doccaz/mister-tty2oled-esp32/docs/protocol.md

# Wire protocol

115200 baud, line-based ASCII commands terminated by `\n`. The firmware
sends `ttyrdy;` once after boot, then `ttyack;` (no trailing newline)
after each processed command, unless `CMDSTTYACK,0` disables it — the
same handshake the original `tty2oled.sh` daemon expects.

**Commands compatible with the original protocol** (same behavior as
upstream, so an unmodified MiSTer daemon works unchanged):
`CMDCLS`/`cls`, `CMDCLSWU`, `CMDSORG`/`sorg`, `CMDCON,<0-255>`,
`CMDROT,<0|1>`, `CMDTXT,x,y,size,text`, `CMDGEO,type,x,y,w,h,fill`,
`CMDSNAM`, `CMDDOFF`, `CMDDON`, `CMDDUPD`, `CMDSECD,<ms>`, `CMDSHCD`,
`CMDSTTYACK,<0|1>`, `CMDRESET`, `CMDSAVER,<mode>,<interval>,<logotime>`
(parses the original's full grammar; implements simple blank-after-idle,
not its animated multi-screen screensaver), `CMDSWSAVER,<0|1>`, and a
bare line with no `CMD` prefix (legacy plain-corename fallback).

**Also implemented, new but original-protocol-shaped**: `CMDBYE`,
`CMDTEST`, `CMDSHSYSHW` (cosmetic/diagnostic screens built from
primitives, not the original's bitmap assets), `CMDHWINF` (replies
`HW<id>;<version>;`: `HWGC9A01C`, or `HWCYD28` on the CYD), `CMDCLST,<transition>,<color>` (solid-color
fill), `CMDSPIC[,<effect>]` (redisplay the last picture with a new
transition), `CMDSSCP` (redisplay at reduced size), `CMDSETTIME,<epoch>`
(sets the device clock; `tty2oled.sh` sends it at startup) and `CMDSHTIME`
(shows the clock as HH:MM plus date; not persisted across reboots).

**Legacy picture transfer**: `CMDCOR,<name>,<effect>` or `CMDAPD,...`
followed by a blocking, fixed-size read of exactly 2048 (1bpp XBM) or
8192 (4bpp grayscale "GSC") raw bytes, classified purely by byte count —
identical to upstream. Source images are 256×64; on the round display
they're scaled to fit (not cropped), since the safe display area is the
same 4:1 aspect ratio as the source.

**Full-color art**: `CMDCORC,<name>,<effect>,<durationMs>,<length>\n`
followed by exactly `<length>` raw JPEG bytes, length-prefixed (not
size-classified, so it isn't subject to the legacy path's fixed-size
truncation behavior). Decoded on-device and revealed with a transition
effect over `durationMs`. Effect ids (shared between firmware and web
app):

| id | effect |
|---|---|
| 0 | none (instant cut) |
| 1 | wipe left → right |
| 2 | wipe right → left |
| 3 | wipe top → bottom |
| 4 | iris (expand from center) |
| 5 | fade (cross-dissolve) |

## Over WiFi

The same command grammar is also reachable over a WebSocket on port 81
once the device has joined your network (see [First boot: WiFi
setup](setup.md#first-boot-wifi-setup)) — `ws://tty2oled-XXXX.local:81/`,
advertised via mDNS as `_ws._tcp`. `CMDCORC`'s JPEG payload is sent as a
text header frame followed by the image chunked into small binary
frames, rather than one big length-prefixed blob — this keeps every
allocation the device's WebSocket library needs to make small and
constant regardless of image size. Legacy `CMDCOR`/`CMDAPD` (raw
XBM/GSC) aren't supported over this transport — that grammar exists for
real-MiSTer-over-serial compatibility, and a WiFi client always has the
modern JPEG path available instead.
