doccaz/mister-tty2oled-esp32/case/sunton_2424s012_stand.stl

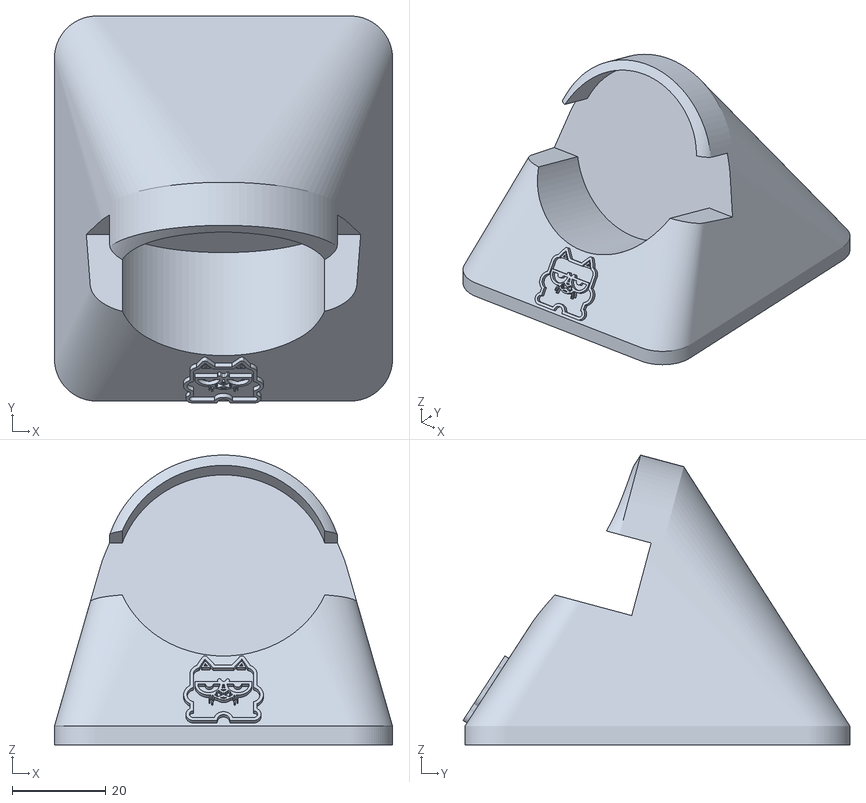
[picture p6: CAD file, 2026-10-17]
case/sunton_2424s012_stand.stl
72.0 x 82.4 x 61.7
