doccaz/mister-tty2oled-esp32/case/sunton_2424s012_back.stl

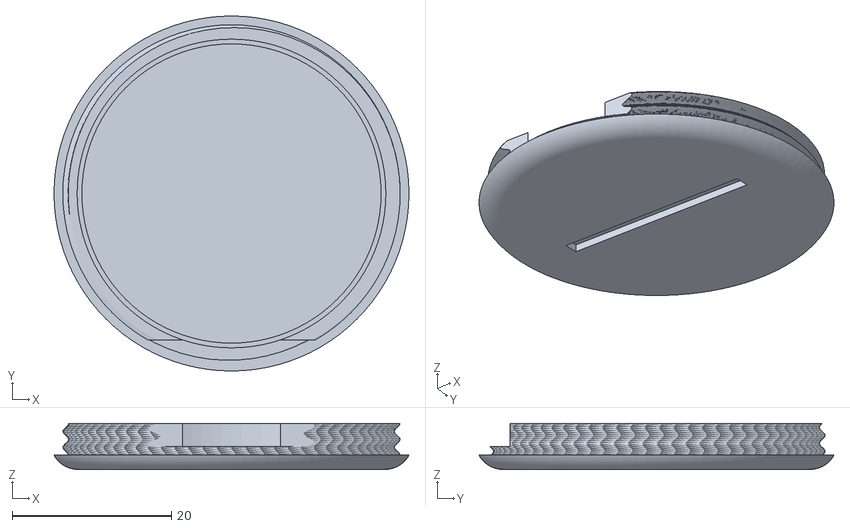
[picture p7: CAD file, 2026-10-17]
case/sunton_2424s012_back.stl
44.6 x 44.6 x 5.79
