doccaz/mister-tty2oled-esp32/case/sunton_2424s012_front.stl

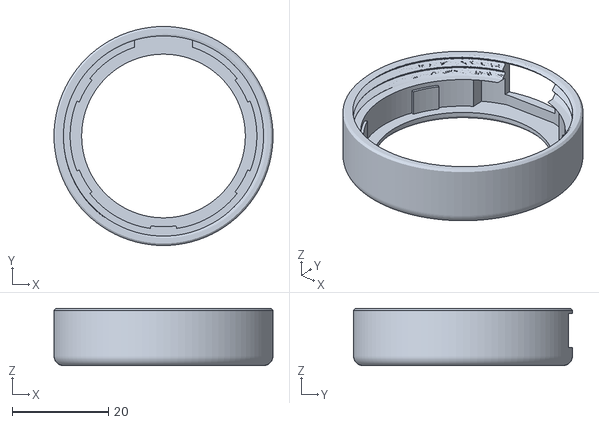
[picture p8: CAD file, 2026-10-17]
case/sunton_2424s012_front.stl
45.5 x 45.5 x 11.9
