doccaz/mister-tty2oled-esp32/case/mister_kun_logo.scad

// MiSTer-Kun mascot, black layer only (outline, glasses, eyes, nose, whiskers), as one 2D
// polygon (even-odd holes), centred and normalised to width 1. Height is 0.9647.
// Artwork: "MiSTer-Kun", created by GitHub user HeWhoisRed for the MiSTer FPGA project and
// remastered by baxysquare (https://github.com/baxysquare/mister_kun), a gift to the MiSTer
// community to use and remix as people wish; a simple credit is appreciated (see
// mister_kun_CREDITS.txt). Derived from mister_kun_bw.svg by compositing its black and white
// layers and simplifying the curves.
kun_h = 0.96474;
module kun_logo2d() {
  polygon(points = [[-0.07341,-0.45040],[-0.07008,-0.44086],[-0.06294,-0.42783],[-0.05354,-0.41658],[-0.04221,-0.40738],[-0.02931,-0.40047],[-0.02000,-0.39728],[-0.00524,-0.39480],[0.00493,-0.39480],[0.01969,-0.39728],[0.03345,-0.40250],[0.04587,-0.41020],[0.05659,-0.42012],[0.06528,-0.43199],[0.06977,-0.44086],[0.07310,-0.45040],[0.08190,-0.48237],[0.38303,-0.48209],[0.39731,-0.47991],[0.41087,-0.47570],[0.42352,-0.46962],[0.43506,-0.46183],[0.44533,-0.45248],[0.45412,-0.44172],[0.46125,-0.42973],[0.46655,-0.41664],[0.46981,-0.40263],[0.47083,-0.39117],[0.47070,-0.38293],[0.46829,-0.36689],[0.46314,-0.35164],[0.45535,-0.33747],[0.44504,-0.32463],[0.43335,-0.31419],[0.41895,-0.30515],[0.41908,-0.23328],[0.43018,-0.22661],[0.44071,-0.21905],[0.45058,-0.21064],[0.45973,-0.20143],[0.46808,-0.19146],[0.47681,-0.17887],[0.48188,-0.17011],[0.48834,-0.15648],[0.49340,-0.14231],[0.49599,-0.13261],[0.49795,-0.12273],[0.49967,-0.10760],[0.49992,-0.09221],[0.49926,-0.08202],[0.49795,-0.07198],[0.49478,-0.05722],[0.49018,-0.04289],[0.48418,-0.02907],[0.47681,-0.01583],[0.46607,-0.00069],[0.45753,0.00908],[0.44577,0.02021],[0.43294,0.03006],[0.41917,0.03852],[0.41908,0.22211],[0.41842,0.23128],[0.41620,0.24480],[0.41256,0.25796],[0.40753,0.27064],[0.40115,0.28272],[0.39618,0.29039],[0.38766,0.30124],[0.37862,0.31055],[0.36876,0.31883],[0.35815,0.32605],[0.34689,0.33215],[0.33506,0.33709],[0.31995,0.36620],[0.30288,0.39628],[0.28283,0.42972],[0.25980,0.46633],[0.25302,0.47414],[0.24760,0.47792],[0.24167,0.48056],[0.23221,0.48236],[0.22262,0.48152],[0.21350,0.47803],[0.20548,0.47185],[0.10549,0.34458],[-0.10679,0.34458],[-0.20678,0.47185],[-0.21481,0.47803],[-0.22392,0.48152],[-0.23351,0.48236],[-0.24297,0.48056],[-0.24890,0.47792],[-0.25432,0.47414],[-0.26110,0.46633],[-0.28423,0.42955],[-0.30439,0.39592],[-0.32152,0.36570],[-0.33664,0.33652],[-0.35110,0.33004],[-0.36201,0.32360],[-0.37470,0.31405],[-0.38398,0.30527],[-0.39400,0.29341],[-0.40152,0.28210],[-0.40776,0.27011],[-0.41269,0.25754],[-0.41714,0.24008],[-0.41908,0.22206],[-0.41917,0.03852],[-0.43558,0.02820],[-0.45061,0.01591],[-0.46401,0.00182],[-0.47681,-0.01583],[-0.48634,-0.03362],[-0.49340,-0.05239],[-0.49795,-0.07198],[-0.49967,-0.08710],[-0.49967,-0.10760],[-0.49705,-0.12769],[-0.49478,-0.13749],[-0.49018,-0.15181],[-0.48187,-0.17011],[-0.47113,-0.18734],[-0.46400,-0.19653],[-0.45525,-0.20613],[-0.44818,-0.21282],[-0.43814,-0.22102],[-0.42746,-0.22837],[-0.41907,-0.23328],[-0.41895,-0.30515],[-0.42871,-0.31088],[-0.43781,-0.31778],[-0.44504,-0.32463],[-0.45300,-0.33412],[-0.45753,-0.34090],[-0.46313,-0.35164],[-0.46725,-0.36299],[-0.46915,-0.37083],[-0.47085,-0.38703],[-0.46981,-0.40263],[-0.46654,-0.41664],[-0.46125,-0.42973],[-0.45790,-0.43587],[-0.44991,-0.44727],[-0.44036,-0.45734],[-0.42944,-0.46593],[-0.41732,-0.47289],[-0.40419,-0.47805],[-0.39025,-0.48126],[-0.38303,-0.48209],[-0.08221,-0.48237],[-0.37707,-0.43885],[-0.38522,-0.43819],[-0.39663,-0.43490],[-0.40355,-0.43131],[-0.41262,-0.42412],[-0.41981,-0.41505],[-0.42339,-0.40814],[-0.42668,-0.39673],[-0.42734,-0.38857],[-0.42664,-0.38042],[-0.42317,-0.36900],[-0.41941,-0.36209],[-0.41190,-0.35302],[-0.40253,-0.34583],[-0.39543,-0.34225],[-0.38384,-0.33895],[-0.37564,-0.33830],[-0.37564,-0.20431],[-0.38924,-0.19948],[-0.39572,-0.19644],[-0.40795,-0.18918],[-0.41911,-0.18047],[-0.42907,-0.17043],[-0.43355,-0.16496],[-0.44146,-0.15318],[-0.44484,-0.14690],[-0.45041,-0.13367],[-0.45424,-0.11964],[-0.45547,-0.11235],[-0.45648,-0.09735],[-0.45547,-0.08235],[-0.45424,-0.07507],[-0.45041,-0.06103],[-0.44484,-0.04780],[-0.44146,-0.04153],[-0.43355,-0.02975],[-0.42425,-0.01910],[-0.41367,-0.00971],[-0.40795,-0.00552],[-0.39572,0.00173],[-0.38924,0.00477],[-0.37564,0.00961],[-0.37542,0.22369],[-0.37475,0.22977],[-0.37214,0.24150],[-0.36796,0.25254],[-0.36232,0.26277],[-0.35536,0.27207],[-0.35142,0.27632],[-0.34271,0.28398],[-0.33796,0.28734],[-0.32778,0.29306],[-0.32238,0.29539],[-0.31102,0.29889],[-0.30510,0.30004],[-0.29575,0.32112],[-0.27759,0.35517],[-0.25751,0.38962],[-0.23101,0.43259],[-0.16065,0.34307],[-0.12858,0.30106],[0.12728,0.30106],[0.15935,0.34307],[0.22971,0.43259],[0.25614,0.38973],[0.27618,0.35535],[0.29435,0.32133],[0.30377,0.30022],[0.30979,0.29916],[0.32134,0.29577],[0.33213,0.29083],[0.34204,0.28447],[0.35092,0.27681],[0.35865,0.26800],[0.36510,0.25816],[0.36779,0.25289],[0.37207,0.24175],[0.37361,0.23591],[0.37541,0.22376],[0.37564,0.21749],[0.37564,0.00961],[0.38924,0.00478],[0.40196,-0.00171],[0.41368,-0.00971],[0.41911,-0.01424],[0.42907,-0.02427],[0.43769,-0.03550],[0.44485,-0.04780],[0.45041,-0.06103],[0.45424,-0.07507],[0.45622,-0.08978],[0.45648,-0.09735],[0.45547,-0.11235],[0.45424,-0.11963],[0.45041,-0.13367],[0.44783,-0.14040],[0.44146,-0.15318],[0.43769,-0.15920],[0.42907,-0.17043],[0.41911,-0.18047],[0.41368,-0.18500],[0.40196,-0.19300],[0.39572,-0.19644],[0.38255,-0.20211],[0.37564,-0.20431],[0.37564,-0.33830],[0.38781,-0.33976],[0.39544,-0.34225],[0.40253,-0.34583],[0.40897,-0.35040],[0.41463,-0.35585],[0.42142,-0.36547],[0.42463,-0.37268],[0.42664,-0.38042],[0.42717,-0.39269],[0.42478,-0.40446],[0.42173,-0.41168],[0.41764,-0.41826],[0.40978,-0.42674],[0.40017,-0.43323],[0.38915,-0.43739],[0.38119,-0.43868],[0.11506,-0.43885],[0.10994,-0.42410],[0.10669,-0.41707],[0.09892,-0.40380],[0.08956,-0.39169],[0.08433,-0.38611],[0.07286,-0.37601],[0.06015,-0.36743],[0.05338,-0.36375],[0.03909,-0.35770],[0.02393,-0.35354],[0.01606,-0.35220],[-0.00015,-0.35111],[-0.01637,-0.35220],[-0.02424,-0.35354],[-0.03940,-0.35770],[-0.05369,-0.36375],[-0.06046,-0.36743],[-0.07317,-0.37601],[-0.07907,-0.38088],[-0.08987,-0.39169],[-0.09923,-0.40380],[-0.10700,-0.41707],[-0.11025,-0.42410],[-0.11537,-0.43885],[-0.17130,0.31120],[-0.16840,0.31222],[-0.16595,0.31490],[-0.16516,0.31846],[-0.16599,0.32142],[-0.21692,0.39398],[-0.22131,0.39803],[-0.22664,0.39980],[-0.23217,0.39936],[-0.23716,0.39676],[-0.24084,0.39206],[-0.27533,0.32116],[-0.27603,0.31765],[-0.27459,0.31386],[-0.27191,0.31175],[-0.26907,0.31115],[-0.24402,0.33378],[-0.22695,0.36888],[-0.20229,0.33378],[0.26983,0.31119],[0.27312,0.31244],[0.27531,0.31502],[0.27604,0.31835],[0.27534,0.32116],[0.24009,0.39343],[0.23601,0.39761],[0.23350,0.39891],[0.22943,0.39985],[0.22526,0.39957],[0.22258,0.39868],[0.21789,0.39520],[0.16643,0.32212],[0.16516,0.31846],[0.16541,0.31627],[0.16675,0.31368],[0.16906,0.31185],[0.17130,0.31120],[0.20229,0.33378],[0.22695,0.36888],[0.24403,0.33378],[-0.14035,-0.22001],[-0.13642,-0.21830],[-0.13424,-0.21465],[-0.13288,-0.19068],[-0.13127,-0.18075],[-0.12636,-0.16317],[-0.11977,-0.14848],[-0.11094,-0.13498],[-0.10281,-0.14055],[-0.09536,-0.14418],[-0.08743,-0.14679],[-0.07820,-0.14855],[-0.07480,-0.14998],[-0.05131,-0.16509],[-0.04087,-0.16983],[-0.03018,-0.17309],[-0.01998,-0.17515],[0.00108,-0.17674],[0.01381,-0.17628],[0.02476,-0.17508],[0.03657,-0.17280],[0.04675,-0.16977],[0.05413,-0.16644],[0.08194,-0.14891],[0.09171,-0.14679],[0.09963,-0.14418],[0.10708,-0.14055],[0.11234,-0.13716],[0.11937,-0.14812],[0.12292,-0.15515],[0.12891,-0.17135],[0.13284,-0.19056],[0.13457,-0.21570],[0.13642,-0.21830],[0.13873,-0.21966],[0.14160,-0.22002],[0.14466,-0.21902],[0.14718,-0.21635],[0.14799,-0.21318],[0.14773,-0.20019],[0.14662,-0.18813],[0.14474,-0.17696],[0.14218,-0.16666],[0.13543,-0.14854],[0.13141,-0.14066],[0.12295,-0.12768],[0.13115,-0.11660],[0.13341,-0.11074],[0.13505,-0.10402],[0.14200,-0.11085],[0.14819,-0.11818],[0.15361,-0.12603],[0.16032,-0.13875],[0.16384,-0.14786],[0.16660,-0.15747],[0.16858,-0.16757],[0.17016,-0.18419],[0.17098,-0.18673],[0.17306,-0.18905],[0.17598,-0.19024],[0.17902,-0.19005],[0.18182,-0.18846],[0.18339,-0.18631],[0.18404,-0.18365],[0.18273,-0.16821],[0.18019,-0.15463],[0.17657,-0.14228],[0.17204,-0.13112],[0.16677,-0.12110],[0.15785,-0.10807],[0.15033,-0.09950],[0.17426,-0.10234],[0.19793,-0.10209],[0.21825,-0.09945],[0.23794,-0.09461],[0.25684,-0.08764],[0.27478,-0.07859],[0.29160,-0.06754],[0.30714,-0.05455],[0.32124,-0.03965],[0.33323,-0.02348],[0.34303,-0.00620],[0.35060,0.01204],[0.35585,0.03107],[0.35872,0.05076],[0.35927,0.09272],[0.35807,0.09693],[0.35494,0.09983],[0.35127,0.10072],[0.07103,0.10072],[0.07505,0.10949],[0.07637,0.11453],[0.07627,0.12161],[0.07471,0.12684],[0.07088,0.13288],[0.06543,0.13748],[0.05878,0.14024],[0.05325,0.14086],[0.04527,0.13935],[0.04104,0.13720],[0.03737,0.13427],[0.03280,0.12793],[0.03001,0.11977],[0.02731,0.11456],[0.02148,0.10758],[0.01444,0.10304],[0.01002,0.10151],[0.00494,0.10068],[-0.00068,0.10068],[-0.00596,0.10155],[-0.01080,0.10332],[-0.01526,0.10602],[-0.01938,0.10966],[-0.02389,0.11525],[-0.02769,0.12191],[-0.03073,0.12968],[-0.03462,0.13452],[-0.03830,0.13737],[-0.04252,0.13944],[-0.05046,0.14087],[-0.05587,0.14026],[-0.06234,0.13768],[-0.06764,0.13337],[-0.07144,0.12764],[-0.07340,0.12082],[-0.07337,0.11454],[-0.07187,0.10904],[-0.06777,0.10072],[-0.35126,0.10072],[-0.35548,0.09952],[-0.35807,0.09693],[-0.35924,0.09337],[-0.35913,0.05743],[-0.35707,0.03757],[-0.35261,0.01830],[-0.34833,0.00586],[-0.34303,-0.00620],[-0.33322,-0.02348],[-0.32124,-0.03965],[-0.30714,-0.05455],[-0.29160,-0.06754],[-0.27478,-0.07859],[-0.25684,-0.08764],[-0.23794,-0.09461],[-0.21825,-0.09945],[-0.19792,-0.10209],[-0.17337,-0.10229],[-0.15033,-0.09950],[-0.15784,-0.10808],[-0.16677,-0.12110],[-0.17204,-0.13112],[-0.17657,-0.14228],[-0.18019,-0.15463],[-0.18273,-0.16821],[-0.18403,-0.18365],[-0.18338,-0.18631],[-0.18181,-0.18846],[-0.17902,-0.19005],[-0.17598,-0.19024],[-0.17306,-0.18905],[-0.17098,-0.18673],[-0.17016,-0.18420],[-0.16858,-0.16757],[-0.16659,-0.15747],[-0.16384,-0.14786],[-0.16032,-0.13875],[-0.15361,-0.12603],[-0.14818,-0.11818],[-0.14200,-0.11085],[-0.13129,-0.10081],[-0.12982,-0.10831],[-0.12747,-0.11537],[-0.12090,-0.12510],[-0.12709,-0.13353],[-0.13543,-0.14854],[-0.14218,-0.16666],[-0.14473,-0.17696],[-0.14662,-0.18813],[-0.14773,-0.20019],[-0.14796,-0.21375],[-0.14718,-0.21635],[-0.14552,-0.21840],[-0.14321,-0.21970],[-0.19526,-0.06562],[-0.20616,-0.06440],[-0.21679,-0.06240],[-0.22711,-0.05965],[-0.24669,-0.05204],[-0.26463,-0.04182],[-0.28065,-0.02926],[-0.28786,-0.02217],[-0.30050,-0.00655],[-0.30587,0.00192],[-0.31056,0.01079],[-0.31454,0.02003],[-0.31777,0.02960],[-0.32022,0.03948],[-0.32185,0.04962],[-0.32263,0.06035],[-0.32128,0.06315],[-0.31863,0.06416],[-0.22866,0.06416],[-0.22751,0.05630],[-0.22369,0.04535],[-0.21988,0.03874],[-0.21250,0.03010],[-0.20340,0.02328],[-0.19653,0.01989],[-0.18527,0.01678],[-0.17725,0.01616],[-0.16923,0.01678],[-0.15797,0.01989],[-0.15110,0.02328],[-0.14200,0.03010],[-0.13462,0.03874],[-0.13081,0.04535],[-0.12699,0.05630],[-0.12585,0.06416],[-0.04958,0.06416],[-0.04649,0.06270],[-0.04557,0.06001],[-0.04636,0.04962],[-0.04799,0.03948],[-0.05044,0.02960],[-0.05367,0.02003],[-0.05764,0.01079],[-0.06770,-0.00655],[-0.08035,-0.02217],[-0.08756,-0.02926],[-0.10358,-0.04182],[-0.11232,-0.04724],[-0.13112,-0.05619],[-0.14109,-0.05965],[-0.16204,-0.06440],[-0.17295,-0.06562],[-0.18410,-0.06604],[0.17295,-0.06562],[0.16205,-0.06440],[0.15142,-0.06240],[0.14110,-0.05965],[0.12152,-0.05204],[0.10358,-0.04182],[0.08756,-0.02926],[0.08035,-0.02217],[0.06771,-0.00655],[0.06234,0.00192],[0.05367,0.02003],[0.05044,0.02960],[0.04799,0.03948],[0.04636,0.04962],[0.04558,0.06035],[0.04693,0.06315],[0.04958,0.06416],[0.12585,0.06416],[0.12699,0.05630],[0.13081,0.04535],[0.13462,0.03874],[0.14201,0.03010],[0.15111,0.02328],[0.15797,0.01989],[0.16924,0.01678],[0.17725,0.01616],[0.18527,0.01678],[0.19653,0.01989],[0.20340,0.02328],[0.21250,0.03010],[0.21988,0.03874],[0.22369,0.04535],[0.22751,0.05630],[0.22866,0.06416],[0.31863,0.06416],[0.32172,0.06270],[0.32264,0.06001],[0.32185,0.04962],[0.32022,0.03948],[0.31777,0.02960],[0.31454,0.02003],[0.31057,0.01079],[0.30051,-0.00655],[0.29449,-0.01459],[0.28065,-0.02926],[0.26463,-0.04182],[0.25588,-0.04724],[0.23709,-0.05619],[0.22712,-0.05965],[0.20616,-0.06440],[0.19526,-0.06562],[0.18411,-0.06604],[-0.01940,0.00676],[-0.01517,0.01932],[-0.01200,0.03221],[-0.00990,0.04539],[-0.00901,0.05611],[0.00052,0.05532],[0.00931,0.05561],[0.01053,0.04255],[0.01279,0.02973],[0.01609,0.01719],[0.02038,0.00498],[-0.00016,0.00609],[-0.02037,0.00429],[-0.00004,-0.05023],[-0.00246,-0.04414],[-0.00821,-0.03760],[-0.01755,-0.03170],[-0.03168,-0.02657],[-0.03254,-0.02524],[-0.03197,-0.02375],[-0.02696,-0.02162],[-0.01799,-0.01960],[0.00000,-0.01830],[0.01799,-0.01960],[0.02696,-0.02162],[0.03212,-0.02391],[0.03251,-0.02544],[0.03168,-0.02657],[0.01756,-0.03170],[0.00821,-0.03760],[0.00246,-0.04414],[0.06203,-0.12352],[0.04783,-0.11949],[0.03430,-0.11338],[0.01677,-0.10274],[0.00000,-0.08976],[-0.01199,-0.09935],[-0.02213,-0.10630],[-0.03430,-0.11338],[-0.04782,-0.11948],[-0.06203,-0.12352],[-0.06918,-0.12442],[-0.07625,-0.12438],[-0.08314,-0.12328],[-0.08979,-0.12097],[-0.09443,-0.11827],[-0.08622,-0.11254],[-0.07691,-0.10711],[-0.07579,-0.10529],[-0.07525,-0.10268],[-0.07659,-0.09850],[-0.08001,-0.09599],[-0.08430,-0.09595],[-0.09601,-0.10227],[-0.10474,-0.10870],[-0.10736,-0.10541],[-0.10874,-0.10103],[-0.10965,-0.09485],[-0.10935,-0.08672],[-0.09727,-0.08152],[-0.08544,-0.07794],[-0.08277,-0.07613],[-0.08108,-0.07282],[-0.08121,-0.06951],[-0.08282,-0.06666],[-0.08547,-0.06490],[-0.08957,-0.06466],[-0.10217,-0.06846],[-0.09797,-0.06289],[-0.09059,-0.05561],[-0.06901,-0.03767],[-0.05881,-0.03000],[-0.05798,-0.03533],[-0.05614,-0.04049],[-0.05266,-0.04598],[-0.04916,-0.04934],[-0.04176,-0.05317],[-0.03130,-0.05467],[-0.02982,-0.05866],[-0.02734,-0.06253],[-0.02310,-0.06665],[-0.01910,-0.06917],[-0.01100,-0.07204],[0.00000,-0.07316],[0.01100,-0.07204],[0.01910,-0.06917],[0.02311,-0.06665],[0.02734,-0.06253],[0.02983,-0.05866],[0.03130,-0.05467],[0.04176,-0.05317],[0.04916,-0.04934],[0.05266,-0.04598],[0.05614,-0.04049],[0.05798,-0.03533],[0.05881,-0.03000],[0.06901,-0.03767],[0.09059,-0.05561],[0.09798,-0.06289],[0.10218,-0.06846],[0.08957,-0.06466],[0.08548,-0.06489],[0.08248,-0.06706],[0.08109,-0.07005],[0.08122,-0.07333],[0.08277,-0.07612],[0.08544,-0.07794],[0.09718,-0.08148],[0.10935,-0.08671],[0.10965,-0.08959],[0.10965,-0.09485],[0.10874,-0.10103],[0.10736,-0.10541],[0.10474,-0.10870],[0.09601,-0.10227],[0.08430,-0.09596],[0.08212,-0.09563],[0.07951,-0.09618],[0.07730,-0.09767],[0.07600,-0.09945],[0.07535,-0.10376],[0.07729,-0.10752],[0.08850,-0.11409],[0.09431,-0.11835],[0.08979,-0.12097],[0.08314,-0.12328],[0.07625,-0.12438],[0.06918,-0.12442],[-0.00369,-0.15231],[-0.01413,-0.15148],[-0.02289,-0.14996],[-0.03187,-0.14746],[-0.04031,-0.14383],[-0.03155,-0.13980],[-0.01877,-0.13703],[0.00121,-0.13577],[0.01756,-0.13681],[0.03090,-0.14001],[0.03694,-0.14292],[0.04032,-0.14573],[0.03201,-0.14855],[0.02041,-0.15094],[0.00766,-0.15218]],
          paths = [[0,1,2,3,4,5,6,7,8,9,10,11,12,13,14,15,16,17,18,19,20,21,22,23,24,25,26,27,28,29,30,31,32,33,34,35,36,37,38,39,40,41,42,43,44,45,46,47,48,49,50,51,52,53,54,55,56,57,58,59,60,61,62,63,64,65,66,67,68,69,70,71,72,73,74,75,76,77,78,79,80,81,82,83,84,85,86,87,88,89,90,91,92,93,94,95,96,97,98,99,100,101,102,103,104,105,106,107,108,109,110,111,112,113,114,115,116,117,118,119,120,121,122,123,124,125,126,127,128,129,130,131,132,133,134,135,136,137,138,139,140,141,142,143,144,145,146,147,148,149,150],[151,152,153,154,155,156,157,158,159,160,161,162,163,164,165,166,167,168,169,170,171,172,173,174,175,176,177,178,179,180,181,182,183,184,185,186,187,188,189,190,191,192,193,194,195,196,197,198,199,200,201,202,203,204,205,206,207,208,209,210,211,212,213,214,215,216,217,218,219,220,221,222,223,224,225,226,227,228,229,230,231,232,233,234,235,236,237,238,239,240,241,242,243,244,245,246,247,248,249,250,251,252,253,254,255,256,257,258,259,260,261,262,263,264,265,266,267,268,269,270,271,272,273,274,275,276,277,278,279,280,281,282,283,284,285,286,287,288,289,290,291,292,293,294,295,296,297],[298,299,300,301,302,303,304,305,306,307,308,309,310,311,312,313],[314,315,316],[317,318,319,320,321,322,323,324,325,326,327,328,329,330,331,332,333,334],[335,336,337],[338,339,340,341,342,343,344,345,346,347,348,349,350,351,352,353,354,355,356,357,358,359,360,361,362,363,364,365,366,367,368,369,370,371,372,373,374,375,376,377,378,379,380,381,382,383,384,385,386,387,388,389,390,391,392,393,394,395,396,397,398,399,400,401,402,403,404,405,406,407,408,409,410,411,412,413,414,415,416,417,418,419,420,421,422,423,424,425,426,427,428,429,430,431,432,433,434,435,436,437,438,439,440,441,442,443,444,445,446,447,448,449,450,451,452,453,454,455,456,457,458,459,460,461,462,463,464,465,466,467,468,469,470,471,472,473,474,475,476,477,478,479,480,481,482,483,484,485,486,487,488,489,490,491,492,493,494,495,496,497,498,499,500,501,502,503,504,505,506,507,508,509,510,511,512,513,514,515,516,517,518,519,520],[521,522,523,524,525,526,527,528,529,530,531,532,533,534,535,536,537,538,539,540,541,542,543,544,545,546,547,548,549,550,551,552,553,554,555,556,557,558,559,560,561,562,563,564,565,566,567,568,569,570,571,572,573],[574,575,576,577,578,579,580,581,582,583,584,585,586,587,588,589,590,591,592,593,594,595,596,597,598,599,600,601,602,603,604,605,606,607,608,609,610,611,612,613,614,615,616,617,618,619,620,621,622,623,624,625],[626,627,628,629,630,631,632,633,634,635,636,637,638],[639,640,641,642,643,644,645,646,647,648,649,650,651,652,653,654,655,656],[657,658,659,660,661,662,663,664,665,666,667,668,669,670,671,672,673,674,675,676,677,678,679,680,681,682,683,684,685,686,687,688,689,690,691,692,693,694,695,696,697,698,699,700,701,702,703,704,705,706,707,708,709,710,711,712,713,714,715,716,717,718,719,720,721,722,723,724,725,726,727,728,729,730,731,732,733,734,735,736,737,738,739,740,741,742,743,744,745,746,747,748,749,750,751,752,753],[754,755,756,757,758,759,760,761,762,763,764,765,766,767,768]]);
}
