doccaz/mister-tty2oled-esp32/firmware/src/pins.h

// SPDX-License-Identifier: GPL-3.0-or-later
// Copyright (C) 2026 Erico Mendonca

#pragma once

// -----------------------------------------------------------------------
// GPIO pin assignments for the ESP32-C3-mini + GC9A01 round display.
// Edit this block to match your board's actual silkscreen/wiring - these
// are sane defaults that avoid the C3's strapping pins (GPIO2, 8, 9), its
// fixed native-USB pins (GPIO18/19, used automatically by Serial and never
// wired here), the in-package flash pins on FN4/FH4 modules (GPIO11-17),
// and GPIO5/6, which this board's onboard 0.42" SSD1306 OLED (72x40,
// driven as a 128x64 panel) uses as fixed I2C SDA/SCL - not
// user-selectable, since it's built into the board rather than wired by
// hand. GPIO20/21 are deliberately left unclaimed for the Serial0 debug
// UART (see protocol.cpp's DBG_ENABLED).
// -----------------------------------------------------------------------

// Panel geometry and bus. Every board but the CYD drives a 240x240 round GC9A01 over the
// global SPI; the CYD is a 320x240 ILI9341 on HSPI. The firmware always draws a 240x240
// canvas, which the driver places PANEL_OFF_X/Y into the panel.
#if defined(BOARD_CYD)
// ESP32-2432S028 "Cheap Yellow Display" (classic ESP32). Pins from the ASCII-Aquarium
// projects; colour settings (inversion off, RGB order, landscape) and the pins confirmed
// by a probe on the owner's board (2026-10-24).
#define PANEL_ILI9341 1
#define PANEL_W      320
#define PANEL_H      240
#define PANEL_OFF_X  40
#define PANEL_OFF_Y  0
#define LCD_SPI      lcdSpi
#define LCD_SPI_HZ   40000000
#define PIN_LCD_SCLK 14
#define PIN_LCD_MOSI 13
#define PIN_LCD_MISO 12
#define PIN_LCD_CS   15
#define PIN_LCD_DC   2
#define PIN_LCD_RST  4    // also the red LED; pulsed at boot, then held high (LED off)
#define PIN_LCD_BL   21   // PWM works
#define PIN_LED_G    16   // RGB LED is active low: drive high to switch it off
#define PIN_LED_B    17
#define PIN_LDR      34   // photoresistor divider, ADC1 (input only)
// XPT2046 resistive touch on its own pins (read with software SPI, see touch.cpp)
#define PIN_TOUCH_CS   33
#define PIN_TOUCH_CLK  25
#define PIN_TOUCH_MOSI 32
#define PIN_TOUCH_MISO 39
#define PIN_TOUCH_IRQ  36
#elif defined(BOARD_2424S012)
// Sunton ESP32-2424S012C (1.28" round, all-in-one ESP32-C3-MINI-1U board).
// Display is soldered on, pins fixed by the board. RST is not routed to a
// GPIO (tied to the board reset), so PIN_LCD_RST is -1 and gc9a01.cpp
// uses the SWRESET command instead. Capacitive-touch variants wire
// CST816S to GPIO0/1/4/5; this firmware doesn't use touch.
#define PIN_LCD_SCLK 6
#define PIN_LCD_MOSI 7
#define PIN_LCD_CS   10
#define PIN_LCD_DC   2
#define PIN_LCD_RST  -1
#define PIN_LCD_BL   3   // backlight, must be PWM (LEDC) capable
#else
#define PIN_LCD_SCLK 4
#define PIN_LCD_MOSI 0
#define PIN_LCD_CS   7
#define PIN_LCD_DC   1
#define PIN_LCD_RST  10
#define PIN_LCD_BL   3   // backlight, must be PWM (LEDC) capable
#endif

#ifndef PANEL_W
#define PANEL_W      240
#define PANEL_H      240
#define PANEL_OFF_X  0
#define PANEL_OFF_Y  0
#define LCD_SPI      SPI
#define LCD_SPI_HZ   10000000
#endif

// GC9A01 panels are write-only in this design; no MISO wiring needed.

// Onboard 0.42" SSD1306 OLED (72x40 visible, 128x64 controller RAM),
// status display. Fixed pins on this board variant.
#define PIN_OLED_SDA 5
#define PIN_OLED_SCL 6

// Onboard "BOOT" pushbutton, repurposed at runtime as a screensaver wake
// button, an AP-mode WiFi-QR toggle, and a factory-reset trigger when
// held 10s continuously (all in protocol.cpp's protocol_button_check()).
// GPIO9 is a strapping pin (pulled low at reset = download mode) - that
// only matters during the reset/power-on instant, not while running, so
// reading it as a plain input afterward is safe - but it also means the
// factory-reset hold must start *after* boot, not across a physical
// power-cycle/reset (holding it low through reset puts the ROM
// bootloader into UART download mode instead of running the app at all).
// Active-low: pressed = LOW.
#if defined(BOARD_CYD)
#define PIN_WAKE_BTN 0   // BOOT button; touch can take over later
#else
#define PIN_WAKE_BTN 9
#endif
