doccaz/mister-tty2oled-esp32/firmware/src/protocol.cpp

// SPDX-License-Identifier: GPL-3.0-or-later
// Copyright (C) 2026 Erico Mendonca

#include "protocol.h"
#include "display.h"
#include "auto_brightness.h"
#include "led_status.h"
#include "touch.h"
#include "oled_status.h"
#include "pins.h"
#include "version.h"
#include "wifi_manager.h"
#include "time_manager.h"
#include "device_settings.h"
#include "mqtt_client.h"
#include "diag.h"
#include <Arduino.h>
#include <cstring>
#include <sys/time.h>
#include <time.h>

namespace {

// Legacy fixed-size picture buffer: 8192 bytes covers both the 2048-byte
// 1bpp XBM and 8192-byte 4bpp GSC payloads (256x64 source), exactly as in
// the original firmware's logoBin[8192].
constexpr size_t LEGACY_BUF_SIZE = 8192;
uint8_t legacyBuf[LEGACY_BUF_SIZE];

// New color art buffer: length-prefixed, so unlike the legacy path this
// isn't classified by byte count. Static, not malloc'd - found by testing
// against real hardware that malloc(40000) failed intermittently despite
// tens of KB of nominally "free" heap, because the C3's heap was
// fragmented enough that no single 40KB contiguous block was available.
// The failure was silent to the actual bug hunt: handleColorPicture()
// returned immediately on OOM *before* ever reading the incoming JPEG
// bytes off the wire, leaving them to be misread as garbage commands by
// the main loop - which is what all the earlier "corruption" actually
// was. 20000 bytes comfortably covers a compressed 240x240 JPEG (test
// images ran 1.5-10KB) while leaving more RAM headroom than the original
// 40000 cap did.
constexpr size_t COLOR_BUF_MAX = 20000;
uint8_t colorBuf[COLOR_BUF_MAX];

// The time itself (NTP, or the MiSTer's CMDSETTIME as a fallback) lives in
// time_manager.cpp; this just draws it.
void showClock() {
  String hm, date;
  if (!time_get_strings(hm, date)) {
    display_show_corename("Time not set!");
    return;
  }
  display_show_clock(hm, date);
}

String actCorename = "No Core loaded";
int cDelay = 15;         // ms delay before ttyack;, mirrors original cDelay
bool sendTTYACK = true;  // CMDSTTYACK toggle
unsigned long lastActivityMs = 0; // millis() of last dispatched line - serial RX activity only, for oled_status.cpp's "RX" indicator

// Idle-timer input for the screensaver specifically - unlike
// lastActivityMs, this is also touched by the GPIO9 wake button, so
// holding/pressing it counts as activity without making oled_status.cpp's
// serial-RX indicator lie about receiving a command that never arrived.
unsigned long lastWakeMs = 0;

constexpr uint16_t DEFAULT_TRANSITION_MS = 600; // CMDSPIC has no duration param in the wire format

// Tracks which buffer/kind the last successfully-drawn picture came from,
// so CMDSPIC/CMDSSCP can redisplay it without needing the MiSTer to
// resend the bytes - legacyBuf/colorBuf/g_frame already persist between
// commands, this just remembers which one is current.
enum class PictureKind { NONE, XBM, GSC, JPEG };
PictureKind lastPictureKind = PictureKind::NONE;

// CMDSAVER/CMDSWSAVER: parses the reference's full <mode>,<interval>,
// <logotime> grammar (so a real tty2oled.sh never errors) but only
// implements simple blank-on-idle, not the original's animated
// multi-screen/starfield/toaster screensaver system - see CLAUDE.md.
bool saverEnabled = false;
unsigned long saverIntervalMs = 60000;
bool saverBlanked = false;

// Idle clock (a setting on the device's web page, not a MiSTer command): after
// clockIdleMs with nothing received, the clock replaces the picture, refreshed
// each minute; any activity brings the picture back. Runs before the blank
// above: clock first, then dark. 0 = off.
unsigned long clockIdleMs = 0;
enum class IdleStage { NORMAL, CLOCK, BLANK };
IdleStage idleStage = IdleStage::NORMAL;
int lastClockMinute = -1;

// Debug channel: hardware UART0 (GPIO20/21, via an external USB-serial
// adapter), completely independent of the native USB-CDC "Serial" object
// used for the actual protocol - useful for diagnosing anything wrong with
// Serial/HWCDC itself without the debug output being affected by the same
// bug. Disabled by default now that the CMDCORC pipeline is confirmed
// working end-to-end on real hardware; flip to 1 to bring it back.
#define DBG_ENABLED 0
#if DBG_ENABLED
#define DBG(...) Serial0.printf(__VA_ARGS__)
#else
#define DBG(...)
#endif

String splitField(const String &s, int index) {
  int start = 0;
  int comma = -1;
  for (int i = 0; i <= index; i++) {
    comma = s.indexOf(',', start);
    if (comma == -1) {
      if (i == index) return s.substring(start);
      return "";
    }
    if (i == index) return s.substring(start, comma);
    start = comma + 1;
  }
  return "";
}

// Clamps to our curated 1..5 effect set (see transitionReveal() in
// display.cpp) and resolves -1 ("no parameter"/"random", matching the
// reference's convention) to a random pick - shared by every command that
// takes a transition effect, so -1 means the same thing everywhere.
uint8_t resolveEffect(int t) {
  if (t < -1) t = -1;
  if (t > 5) t = 5;
  if (t == -1) t = random(1, 6); // random(min, max+1)
  return (uint8_t)t;
}

// Like splitField(), but returns -1 (not 0) when the field is absent -
// the convention CMDSPIC/CMDCOR/CMDAPD use for "no effect given" before
// resolveEffect() turns that into a random pick.
int splitFieldEffect(const String &cmd, int index) {
  String f = splitField(cmd, index);
  return f.length() ? f.toInt() : -1;
}

// Redraws whatever was last shown (picture or corename text), with the
// given transition effect. Backs CMDSPIC directly, and is also what makes
// CMDDON/the screensaver's wake-up actually restore content: display_off()
// blanks by content (see its comment in display.cpp - backlight PWM alone
// is confirmed to have no effect on at least one real GC9A01 module), so
// display_on() alone doesn't bring anything back - this does.
void redisplayCurrent(uint8_t effect) {
  switch (lastPictureKind) {
    case PictureKind::JPEG:
      display_replay_jpeg(effect, DEFAULT_TRANSITION_MS);
      break;
    case PictureKind::XBM:
      display_draw_legacy_xbm(legacyBuf, effect);
      break;
    case PictureKind::GSC:
      display_draw_legacy_gsc(legacyBuf, effect);
      break;
    case PictureKind::NONE:
      display_show_corename(actCorename);
      break;
  }
}

// Reads exactly `size` bytes into buf, matching the original's blocking
// Serial.readBytes() + fixed 500ms timeout behavior.
size_t readFixed(uint8_t *buf, size_t size) {
  Serial.setTimeout(500);
  return Serial.readBytes(reinterpret_cast<char *>(buf), size);
}

// Reads exactly `size` bytes into buf, looping until satisfied or an
// overall timeout elapses. Used for the new length-prefixed color command
// so slow/chunked writes from a browser don't truncate like the legacy
// fixed-size read would.
bool readExact(uint8_t *buf, size_t size, uint32_t timeoutMs = 5000) {
  // Stream::readBytes()/timedRead() busy-spin calling read() with no
  // yield() when nothing's immediately available. On this single-core
  // chip that can starve whatever FreeRTOS task actually feeds bytes from
  // the USB hardware into HWCDC's rx_queue in the first place, since our
  // own tight loop never gives it a chance to run - found by testing
  // against real hardware: host-side write() of the full JPEG completed
  // in ~18ms, but the device only received a couple KB over a 5 SECOND
  // timeout, a pathological slowdown consistent with exactly this kind of
  // task starvation, not a real transfer-rate limit. Explicitly yielding
  // whenever no data is immediately available fixes it.
  DBG("readExact: requesting %u bytes, avail=%d\n", (unsigned)size, Serial.available());
  size_t got = 0;
  uint32_t start = millis();
  uint32_t lastProgress = start;
  while (got < size) {
    if (Serial.available()) {
      int n = Serial.readBytes(reinterpret_cast<char *>(buf + got), min((size_t)Serial.available(), size - got));
      if (n > 0) {
        got += n;
        lastProgress = millis();
        continue;
      }
    }
    if (millis() - lastProgress > timeoutMs) break; // timeout since last byte, not since start
    yield();
  }
  uint32_t t1 = millis();
  DBG("readExact: got %u of %u in %u ms\n", (unsigned)got, (unsigned)size, (unsigned)(t1 - start));
  if (got != size) {
    display_show_error("got " + String((unsigned)got) + " of " + String((unsigned)size));
  }
  return got == size;
}

// WS transfer state, shared with ws_protocol.cpp via protocol.h. Owned
// here alongside colorBuf/lastPictureKind, which it draws into/updates on
// completion - same static buffer the serial CMDCORC path uses, just
// filled by small chunked appends instead of one blocking read.
bool wsXferActive = false;
String wsXferName;
uint8_t wsXferEffect = 0;
uint16_t wsXferDurationMs = 0;
size_t wsXferTotal = 0;
size_t wsXferReceived = 0;

void handleLegacyPicture(const String &cmd, int prefixLen) {
  if (wsXferActive) {
    // A WS transfer spans multiple loop() iterations while chunks arrive
    // (unlike this function's own single blocking read), so a serial
    // CMDCOR/CMDAPD landing mid-transfer would race the shared legacyBuf -
    // reject rather than corrupt it.
    display_show_error("WiFi picture xfer in progress");
    return;
  }
  String rest = cmd.substring(prefixLen);
  int comma = rest.indexOf(',');
  int effect = -1;
  if (comma == -1) {
    actCorename = rest;
  } else {
    actCorename = rest.substring(0, comma);
    effect = rest.substring(comma + 1).toInt();
  }

  oled_status_suspend();
  led_transfer_begin();
  size_t n = readFixed(legacyBuf, LEGACY_BUF_SIZE);
  led_transfer_end(n == 2048 || n == 8192);
  oled_status_resume();
  if (n == 2048 || n == 8192) display_new_picture(); // new art: pick this picture's tint
  if (n == 2048) {
    display_draw_legacy_xbm(legacyBuf, resolveEffect(effect));
    lastPictureKind = PictureKind::XBM;
  } else if (n == 8192) {
    display_draw_legacy_gsc(legacyBuf, resolveEffect(effect));
    lastPictureKind = PictureKind::GSC;
  } else {
    display_show_error("Picture xfer error: " + String(n));
  }
}

// CMDCORC,<name>,<effect>,<durationMs>,<length>\n + <length> raw JPEG bytes.
// Length-prefixed by design (see readExact) - the legacy byte-count
// classification trick doesn't work for variable-length JPEG.
void handleColorPicture(const String &cmd) {
  if (wsXferActive) {
    display_show_error("WiFi picture xfer in progress");
    return;
  }
  DBG("handleColorPicture: free heap=%u cmd='%s' len=%u\n", (unsigned)ESP.getFreeHeap(), cmd.c_str(), (unsigned)cmd.length());
  String name = splitField(cmd, 1);
  int effect = splitField(cmd, 2).toInt();
  long durationMs = splitField(cmd, 3).toInt();
  long length = splitField(cmd, 4).toInt();
  DBG("parsed name='%s' effect=%d durationMs=%ld length=%ld\n", name.c_str(), effect, durationMs, length);

  if (length <= 0 || (size_t)length > COLOR_BUF_MAX) {
    DBG("REJECT bad length\n");
    display_show_error("Bad CMDCORC length: " + String(length));
    return;
  }

  DBG("calling readExact...\n");
  oled_status_suspend();
  led_transfer_begin();
  bool ok = readExact(colorBuf, (size_t)length);
  led_transfer_end(ok);
  oled_status_resume();
  DBG("readExact returned %d\n", ok);
  if (!ok) {
    return; // readExact() already showed+froze on the got/size mismatch
  }

  actCorename = name;
  display_draw_jpeg(colorBuf, (size_t)length, (uint8_t)effect, (uint16_t)durationMs);
  lastPictureKind = PictureKind::JPEG;
}

} // namespace

// The shared command grammar - see protocol.h's declaration for why
// CMDHWINF and the picture-transfer commands aren't part of this.
void protocol_dispatch_line(const String &cmd) {
  protocol_note_command(cmd);
  if (cmd == "CMDNULL") {
    // no-op test command
  } else if (cmd == "cls" || cmd == "CMDCLS") {
    display_clear();
    display_flush();
  } else if (cmd == "CMDCLSWU") {
    display_clear();
  } else if (cmd == "sorg" || cmd == "CMDSORG") {
    display_show_start_screen();
  } else if (cmd.startsWith("CMDSECD")) {
    cDelay = cmd.substring(8).toInt();
  } else if (cmd == "CMDSHCD") {
    display_show_error("cDelay: " + String(cDelay));
  } else if (cmd == "CMDSNAM") {
    display_show_corename(actCorename);
  } else if (cmd == "CMDDOFF") {
    display_off();
  } else if (cmd == "CMDDON") {
    display_on();
    redisplayCurrent(0); // instant - display_off() blanked by content, not just backlight, see its comment
  } else if (cmd == "CMDDUPD") {
    display_flush();
  } else if (cmd.startsWith("CMDTXT")) {
    // CMDTXT,x,y,fontSize,text
    int16_t x = splitField(cmd, 1).toInt();
    int16_t y = splitField(cmd, 2).toInt();
    uint8_t fs = (uint8_t)splitField(cmd, 3).toInt();
    String text = splitField(cmd, 4);
    display_draw_text(x, y, fs, text);
  } else if (cmd.startsWith("CMDGEO")) {
    // CMDGEO,type,x,y,w_or_r,h,fill  (type: 0=rect,1=circle,2=line(x2 in w,y2 in h))
    int type = splitField(cmd, 1).toInt();
    int16_t x = splitField(cmd, 2).toInt();
    int16_t y = splitField(cmd, 3).toInt();
    int16_t w = splitField(cmd, 4).toInt();
    int16_t h = splitField(cmd, 5).toInt();
    int fill = splitField(cmd, 6).toInt();
    if (type == 0) display_draw_rect(x, y, w, h, fill != 0);
    else if (type == 1) display_draw_circle(x, y, w, fill != 0);
    else if (type == 2) display_draw_line(x, y, w, h);
  } else if (cmd.startsWith("CMDCORC")) {
    // Must be checked before the CMDCOR/CMDAPD legacy branch below:
    // "CMDCORC,..." also starts with the substring "CMDCOR", so with the
    // checks in the other order every CMDCORC command was silently
    // swallowed by the legacy handler (reading a fixed 8192-byte legacy
    // buffer against a variable-length JPEG payload - byte-count mismatch,
    // "Picture xfer error"). Found by testing against real hardware.
    handleColorPicture(cmd);
  } else if (cmd.startsWith("CMDAPD") || cmd.startsWith("CMDCOR")) {
    handleLegacyPicture(cmd, 6);
  } else if (cmd.startsWith("CMDCON")) {
    auto_brightness_override(); // a live CMDCON wins over the light sensor until the next reboot
    display_set_contrast((uint8_t)splitField(cmd, 1).toInt());
  } else if (cmd.startsWith("CMDROT")) {
    display_set_rotation((uint8_t)splitField(cmd, 1).toInt());
  } else if (cmd.startsWith("CMDSTTYACK")) {
    sendTTYACK = splitField(cmd, 1).toInt() != 0;
  } else if (cmd == "CMDBYE") {
    display_show_bye();
  } else if (cmd == "CMDTEST") {
    display_show_test_pattern();
  } else if (cmd == "CMDSHSYSHW") {
    display_show_sysinfo(FW_VERSION);
  } else if (cmd.startsWith("CMDSETTIME")) {
    long epoch = splitField(cmd, 1).toInt();
    if (epoch > 0) time_set_manual_local((time_t)epoch); // ignored once NTP owns the clock
  } else if (cmd == "CMDSHTIME") {
    showClock();
  } else if (cmd == "CMDHWINF") {
    // Reply grammar matches the reference (<hwid>;<version>;), but the id
    // itself is our own - a new device type outside the reference's
    // enum. Only its own installer.sh keys off this string, not
    // tty2oled.sh itself (confirmed against reference/), so an unknown id
    // is safe. No trailing newline: web/src/serial.ts tokenizes on ";",
    // not "\n", matching how ttyack;/ttyrdy; are already sent.
    Serial.print(HW_ID ";");
    Serial.print(FW_VERSION);
    Serial.print(";");
  } else if (cmd.startsWith("CMDCLST")) {
    // CMDCLST,<transition>,<color 0-15> - fill screen with a solid
    // 4bpp-grayscale color and reveal it with a transition. Reused
    // wholesale through the existing legacy-GSC draw path (fill legacyBuf
    // with the solid color, exactly like the reference fills logoBin)
    // rather than adding a separate solid-fill code path, so CMDSPIC/
    // CMDSSCP redisplay of a CMDCLST screen falls out for free.
    String tT = splitField(cmd, 1);
    String cT = splitField(cmd, 2);
    if (tT.length() == 0 || cT.length() == 0) {
      display_show_error("CMDCLST needs transition,color");
    } else {
      int c = cT.toInt();
      if (c < 0) c = 0;
      if (c > 15) c = 15;
      memset(legacyBuf, (uint8_t)((c << 4) | c), LEGACY_BUF_SIZE);
      actCorename = "No Core";
      uint8_t effect = resolveEffect(tT.toInt());
      display_new_picture();
      display_draw_legacy_gsc(legacyBuf, effect);
      lastPictureKind = PictureKind::GSC;
    }
  } else if (cmd.startsWith("CMDSPIC")) {
    // CMDSPIC[,<effect>] - redisplay the last-drawn picture (any kind)
    // with a (possibly random) transition. No redecode: JPEG replays
    // straight from display.cpp's still-resident g_frame, legacy XBM/GSC
    // replays from legacyBuf, which persists between commands already.
    redisplayCurrent(resolveEffect(splitFieldEffect(cmd, 1)));
  } else if (cmd == "CMDSSCP") {
    // Show the last-drawn picture at reduced ("1/4 area") size - no
    // effect parameter, matching the reference.
    switch (lastPictureKind) {
      case PictureKind::JPEG:
        display_draw_jpeg_small();
        break;
      case PictureKind::XBM:
        display_draw_legacy_xbm_small(legacyBuf);
        break;
      case PictureKind::GSC:
        display_draw_legacy_gsc_small(legacyBuf);
        break;
      case PictureKind::NONE:
        display_show_corename(actCorename);
        break;
    }
  } else if (cmd.startsWith("CMDSWSAVER")) {
    int x = splitField(cmd, 1).toInt();
    if (x < 0) x = 0;
    if (x > 1) x = 1;
    saverEnabled = (x == 1);
  } else if (cmd.startsWith("CMDSAVER")) {
    // CMDSAVER,<mode>,<interval>,<logotime> - grammar and range clamps
    // match the reference exactly (mode 0-255, interval 5-600s, logotime
    // 20-600s) so a real tty2oled.sh never errors, but only simple
    // blank-on-idle is implemented (mode>0 => enabled, blank after
    // <interval> seconds idle via the existing display_off()/on()), not
    // the reference's animated starfield/toaster/multi-screen system -
    // see CLAUDE.md "CMDSAVER" for the divergence.
    int m = splitField(cmd, 1).toInt();
    int iv = splitField(cmd, 2).toInt();
    // logotime is parsed for grammar compatibility but intentionally unused.
    if (m < 0) m = 0;
    if (m > 255) m = 255;
    if (iv < 5) iv = 5;
    if (iv > 600) iv = 600;
    saverIntervalMs = (unsigned long)iv * 1000UL;
    saverEnabled = (m > 0);
  } else if (cmd.startsWith("CMDWTX,")) {
    // Diagnostic, not part of the original protocol: WiFi TX power in dBm
    // (2-20), applied live. Some ESP32-C3 Super Mini boards join and hold a
    // link much better below full power; this lets that be tested over the
    // wire. Shown as "txpower" on GET /status.
    wifi_manager_set_tx_power(splitField(cmd, 1).toFloat());
  } else if (cmd == "CMDRESET") {
    ESP.restart();
  } else if (cmd == "QWERTZ") {
    // First transmission from MiSTer after boot; clears the buffer, ignore.
  } else {
    // Bare line, no CMD prefix: legacy text-only corename fallback.
    // This is what makes an unmodified tty2oled.sh usable with zero
    // MiSTer-side changes.
    //
    // A real corename is plain printable text. Anything with control or
    // non-ASCII bytes is some other program probing the port - found on a
    // real MiSTer: Zaparoo's PN532 auto-detect opens every /dev/ttyACM*
    // after each core change and writes 0x55 0x55 0x00... (a PN532 wake-up
    // preamble), which was drawn on the display as a garbage corename.
    for (size_t i = 0; i < cmd.length(); i++) {
      uint8_t c = cmd[i];
      if (c < 0x20 || c > 0x7E) return;
    }
    actCorename = cmd;
    display_show_corename(actCorename);
  }
}

void protocol_init() {
  // The C3's native USB-CDC (HWCDC) defaults to a 256-byte RX queue -
  // nowhere near enough for a multi-KB CMDCORC JPEG burst; the ISR drops
  // bytes silently once it's full (xQueueSendFromISR failing on a full
  // queue), which readExact() sees as bytes that just never arrive.
  //
  // An earlier attempt requested 16384 bytes here, which *silently
  // failed* every single boot (setRxBufferSize() returns 0 on failure,
  // easy to not check) - free heap at this point in setup() is only
  // ~32KB (most of the C3's ~320KB RAM is consumed by our own two large
  // static 240x240 frame buffers in display.cpp, plus ESP-IDF's own
  // startup allocations), and a 16KB queue doesn't reliably fit. Because
  // HWCDC::begin() falls back to creating its own 256-byte default
  // whenever the queue is still NULL, the failed 16384 request left us
  // silently running with the tiny default this entire time - which is
  // the actual root cause of what looked like a mysterious
  // corruption/throughput bug spanning a very long debugging session:
  // real transfers were mostly being dropped by ISR queue overflow, not
  // "corrupted" or slow. 4096 bytes is confirmed (by testing against
  // real hardware, checking the return value) to allocate reliably and
  // is ample headroom for readExact()'s actively-draining read loop.
#if DBG_ENABLED
  Serial0.begin(115200); // independent hardware UART0 debug channel (GPIO20/21), see DBG() above
#endif
  DBG("free heap at protocol_init: %u\n", (unsigned)ESP.getFreeHeap());
  size_t rxSet = Serial.setRxBufferSize(16384);
  DBG("setRxBufferSize(16384) returned %u\n", (unsigned)rxSet);
  if (rxSet == 0) Serial.setRxBufferSize(4096); // fallback if 16384 still doesn't fit
  Serial.setTxBufferSize(2048);
  Serial.begin(115200);
  Serial.setTimeout(500);
  delay(cDelay);
  Serial.print("ttyrdy;");

  // GPIO9 is the C3's onboard "BOOT" pushbutton and a strapping pin, but
  // strapping only matters at reset (pulled low = download mode) - safe
  // to read as a plain input once running. Repurposed here as a
  // screensaver wake button; INPUT_PULLUP is a no-op safety net since the
  // board already pulls it up for the strapping function to work at all.
  pinMode(PIN_WAKE_BTN, INPUT_PULLUP);
}

void protocol_process() {
  if (!Serial.available()) return;

  String line = Serial.readStringUntil('\n');
  line.trim();
  if (line.length() == 0) return;
  DBG("dispatch line len=%u\n", (unsigned)line.length());

  protocol_dispatch_line(line);
  protocol_note_activity();

  if (sendTTYACK) {
    delay(cDelay);
    Serial.print("ttyack;");
  }
}

// Factory reset: hold the wake button 10s continuously *during normal
// operation* - not at power-on. GPIO9 is a strapping pin the ROM
// bootloader samples at reset, so holding it low across an actual
// reset/power-cycle puts the chip in UART download mode and the app
// never runs at all (confirmed on real hardware: holding through power-on
// produced a black screen, not a countdown - the app simply never
// started). Tracking the hold here in the normal loop() instead sidesteps
// that entirely, since by the time app code is running the strap sampling
// window has already passed.
constexpr unsigned long FACTORY_RESET_HOLD_MS = 10000;
constexpr unsigned long FACTORY_RESET_UI_DELAY_MS = 1500; // don't flash the countdown on ordinary short presses

void protocol_button_check() {
  // Touch (CYD) wakes the display like the BOOT button does, and flips the AP-mode QR on a
  // press edge. It deliberately takes no part in the factory-reset hold below: a palm resting
  // on the screen must never wipe the device.
  bool touched = touch_pressed();
  static bool wasTouched = false;
  if (touched) lastWakeMs = millis();
  if (touched && !wasTouched && wifi_manager_is_ap_mode()) display_toggle_wifi_qr();
  wasTouched = touched;

  bool pressed = (digitalRead(PIN_WAKE_BTN) == LOW);

  // Level-based touch of lastWakeMs is unchanged and still idempotent
  // while held - only the screensaver-wake role needs this, and the
  // screensaver isn't ticked in AP mode anyway (see protocol_saver_check()).
  if (pressed) {
    lastWakeMs = millis();
  }

  // AP-mode QR toggle needs an actual press edge (not "is held"), so a
  // single press flips the display once rather than re-triggering every
  // loop() iteration for as long as the button stays down.
  static bool wasPressed = false;
  if (pressed && !wasPressed && wifi_manager_is_ap_mode()) {
    display_toggle_wifi_qr();
  }

  static unsigned long pressStartMs = 0;
  static bool countdownShown = false;
  static uint8_t lastSecShown = 0;

  if (pressed && !wasPressed) {
    pressStartMs = millis();
  }

  if (pressed) {
    unsigned long held = millis() - pressStartMs;
    if (held >= FACTORY_RESET_HOLD_MS) {
      display_show_factory_reset_done();
      wifi_manager_factory_reset(); // clears NVS + ESP.restart(), never returns
    } else if (held >= FACTORY_RESET_UI_DELAY_MS) {
      uint8_t secLeft = (FACTORY_RESET_HOLD_MS - held) / 1000 + 1;
      if (secLeft != lastSecShown) {
        display_show_factory_reset_hold(secLeft);
        lastSecShown = secLeft;
        countdownShown = true;
      }
    }
  } else if (countdownShown) {
    // Released before the full hold - undo the countdown screen.
    if (wifi_manager_is_ap_mode()) {
      wifi_manager_redraw_screen();
    } else {
      protocol_redisplay_current(0);
    }
    countdownShown = false;
    lastSecShown = 0;
  }

  wasPressed = pressed;
}

const String &protocol_get_corename() {
  return actCorename;
}

unsigned long protocol_last_activity_ms() {
  return lastActivityMs;
}

unsigned long protocol_last_wake_ms() {
  return lastWakeMs;
}

static String lastCommand;

void protocol_note_command(const String &line) {
  int comma = line.indexOf(',');
  String verb = comma > 0 ? line.substring(0, comma) : line;
  verb.trim();
  lastCommand = verb.substring(0, 12); // the OLED line is ~17 chars of 4px font, minus the "> " prefix
}

const String &protocol_last_command() {
  return lastCommand;
}

void protocol_note_activity() {
  lastActivityMs = millis();
  lastWakeMs = lastActivityMs;
}

void protocol_saver_check() {
  // No idle-blank during WiFi setup - the AP-status/QR screens should
  // stay up until the button is pressed or WiFi gets configured, not
  // fight the QR toggle with a second idle timer.
  if (wifi_manager_is_ap_mode()) return;

  unsigned long idle = millis() - lastWakeMs;
  bool wantBlank = saverEnabled && idle >= saverIntervalMs;
  struct tm now;
  bool haveTime = time_get_local(now);
  bool wantClock = !wantBlank && clockIdleMs > 0 && idle >= clockIdleMs && haveTime;
  IdleStage want = wantBlank ? IdleStage::BLANK : (wantClock ? IdleStage::CLOCK : IdleStage::NORMAL);

  if (want == idleStage) {
    // Still in the clock stage: redraw when the minute rolls over.
    if (idleStage == IdleStage::CLOCK && now.tm_min != lastClockMinute) {
      lastClockMinute = now.tm_min;
      showClock();
    }
    return;
  }

  // Leaving a stage: undo what it did.
  if (idleStage == IdleStage::BLANK) {
    display_on();
    oled_status_on();
    saverBlanked = false;
  }
  if (want == IdleStage::NORMAL) {
    // A transient MQTT notification may be on screen right now; don't paint over it.
    crumb(C_SAVER_NORMAL);
    if (!mqtt_client_notification_active()) redisplayCurrent(0);
  } else if (want == IdleStage::CLOCK) {
    crumb(C_SAVER_CLOCK);
    lastClockMinute = now.tm_min;
    showClock();
  } else { // BLANK
    crumb(C_SAVER_BLANK);
    display_off();
    oled_status_off(); // an always-on static dashboard burns in a real OLED over time
    saverBlanked = true;
  }
  idleStage = want;
}

const char *protocol_idle_stage() {
  switch (idleStage) {
    case IdleStage::CLOCK: return "clock";
    case IdleStage::BLANK: return "blank";
    default: return "normal";
  }
}

void protocol_apply_settings() {
  const DeviceSettings &c = settingsStore.cfg;
  display_set_contrast(c.contrast);
  auto_brightness_apply_settings();
  led_status_set_enabled(c.transferLed);
  display_set_orientation(c.rotation);
  display_set_tint(c.tintMode, c.tintColor1, c.tintColor2, c.tintDir);
  oled_status_set_idle_sec(c.oledIdleSec);
  clockIdleMs = (unsigned long)c.clockIdleMin * 60000UL;
  // The blank stage's default. A MiSTer CMDSAVER still overrides it live (until
  // the next reboot): tty2oled.sh sends CMDSAVER,0,0,0 at start-up when its own
  // SCREENSAVER setting is "no", which therefore turns this blank off, while the
  // idle clock above is unaffected.
  if (c.blankMin > 0) {
    saverEnabled = true;
    saverIntervalMs = ((unsigned long)c.clockIdleMin + c.blankMin) * 60000UL;
  } else {
    saverEnabled = false;
  }
}

bool protocol_ws_xfer_begin(const String &name, uint8_t effect,
                             uint16_t durationMs, size_t totalLen) {
  if (wsXferActive || totalLen == 0 || totalLen > COLOR_BUF_MAX) return false;
  wsXferActive = true;
  wsXferName = name;
  wsXferEffect = effect;
  wsXferDurationMs = durationMs;
  wsXferTotal = totalLen;
  wsXferReceived = 0;
  led_transfer_begin();
  return true;
}

bool protocol_ws_xfer_append(const uint8_t *data, size_t len) {
  if (!wsXferActive || wsXferReceived + len > wsXferTotal) {
    protocol_ws_xfer_abort();
    return false;
  }
  memcpy(colorBuf + wsXferReceived, data, len);
  wsXferReceived += len;
  return true;
}

bool protocol_ws_xfer_complete() {
  return wsXferActive && wsXferReceived == wsXferTotal;
}

void protocol_ws_xfer_finish() {
  if (!wsXferActive) return;
  led_transfer_end(true);
  actCorename = wsXferName;
  display_draw_jpeg(colorBuf, wsXferTotal, wsXferEffect, wsXferDurationMs);
  lastPictureKind = PictureKind::JPEG;
  wsXferActive = false;
}

void protocol_ws_xfer_finish_transient() {
  if (!wsXferActive) return;
  led_transfer_end(true);
  display_draw_jpeg_transient(colorBuf, wsXferTotal);
  wsXferActive = false;
}

void protocol_ws_xfer_abort() {
  if (wsXferActive) led_transfer_end(false); // an abort after finish (wsXferActive already false) is not a failure
  wsXferActive = false;
}

bool protocol_ws_xfer_in_progress() {
  return wsXferActive;
}

void protocol_redisplay_current(uint8_t effect) {
  redisplayCurrent(effect);
}
