doccaz/mister-tty2oled-esp32/firmware/src/web_portal.cpp

// SPDX-License-Identifier: GPL-3.0-or-later
// Copyright (C) 2026 Erico Mendonca

#include "web_portal.h"
#include "version.h"
#include "mqtt_client.h"
#include "wifi_manager.h"
#include "web_portal_common.h"
#include "device_settings.h"
#include "protocol.h"
#include "diag.h"
#include "time_manager.h"
#include "light_sensor.h"
#include "touch.h"
#include "display.h"
#include <WiFi.h>

// Shared with web_portal_settings.cpp via web_portal_common.h.

// Minimal inline CSS/markup - same "embedded PROGMEM, no filesystem"
// approach as chromecast-esp32/src/web_server.h's _handleRoot(). Kept
// deliberately small: this page's only job is WiFi setup, not the full
// marquee editor (that's web/, over WebSerial). Dark theme with the same
// purple/teal accent pairing as the web app's own header
// (web/src/style.css's gradient title), so the two feel like the same
// project instead of a stock plain-HTML form.
const char PAGE_HEAD[] PROGMEM =
    "<!DOCTYPE html><html><head><meta charset='utf-8'>"
    "<meta name='viewport' content='width=device-width,initial-scale=1'>"
    "<title>tty2oled setup</title>"
    "<style>"
    ":root{--bg:#14141c;--card:#1e1e2a;--border:#33334a;--text:#e8e8f0;"
    "--muted:#9494ab;--accent:#8b6bff;--accent2:#3fd9c7;--danger:#ff6b6b}"
    "*{box-sizing:border-box}"
    "body{font-family:-apple-system,'Segoe UI',Roboto,sans-serif;max-width:440px;"
    "margin:2em auto;padding:0 1em;background:var(--bg);color:var(--text)}"
    "h1{font-size:1.3em;margin:1.4em 0 .4em;background:linear-gradient(90deg,var(--accent),var(--accent2));"
    "-webkit-background-clip:text;background-clip:text;color:transparent;font-weight:700}"
    "h1:first-of-type{margin-top:0}"
    "label{display:block;margin-top:.7em;font-size:.85em;color:var(--muted)}"
    "input,select{width:100%;padding:.55em;margin-top:.25em;background:var(--card);"
    "border:1px solid var(--border);border-radius:6px;color:var(--text);font-size:1em}"
    "input:focus,select:focus{outline:none;border-color:var(--accent)}"
    "input[type=checkbox]{width:auto;margin:0 .4em 0 0;vertical-align:middle}"
    "button{padding:.65em 1.2em;margin-top:1em;background:var(--accent);color:#fff;"
    "border:none;border-radius:6px;font-size:1em;cursor:pointer;transition:background .15s}"
    "button:hover{background:#7857f5}"
    "button.danger{background:var(--danger)}"
    "button.danger:hover{background:#e85555}"
    "button.secondary{background:var(--card);border:1px solid var(--border);margin-left:.5em}"
    "button.secondary:hover{background:#28283a}"
    "p{line-height:1.5}"
    ".pwrow{display:flex;gap:.4em}"
    ".pwrow input{flex:1}"
    ".pwrow button{margin-top:.25em;padding:0 .7em;background:var(--card);"
    "border:1px solid var(--border);color:var(--text)}"
    ".pwrow button:hover{background:#28283a}"
    "#mqttTestResult{display:inline-block;margin-top:1em;font-size:.9em}"
    "code{background:var(--card);border:1px solid var(--border);border-radius:4px;"
    "padding:.1em .4em;font-size:.9em;color:var(--accent2)}"
    ".muted{color:var(--muted);font-size:.9em}"
    "</style></head><body>";

const char PAGE_TAIL[] PROGMEM = "</body></html>";

String htmlEscape(const String &s) {
  String out;
  out.reserve(s.length());
  for (size_t i = 0; i < s.length(); i++) {
    char c = s[i];
    if (c == '&') out += "&amp;";
    else if (c == '<') out += "&lt;";
    else if (c == '>') out += "&gt;";
    else if (c == '"') out += "&quot;";
    else out += c;
  }
  return out;
}

void WebPortal::begin(WifiConfigStore *config, bool apMode) {
  _config = config;
  _apMode = apMode;

  _server.on("/", HTTP_GET, [this]() { handleRoot(); });
  _server.on("/save", HTTP_POST, [this]() { handleSave(); });
  _server.on("/reset", HTTP_POST, [this]() { handleReset(); });
  _server.on("/status", HTTP_GET, [this]() { handleStatus(); });
  _server.on("/scan", HTTP_GET, [this]() { handleScan(); }); // setup form, and "change WiFi" on the settings page
  if (!_apMode) {
    _server.on("/settings", HTTP_GET, [this]() { handleSettings(); });
    _server.on("/settings-part", HTTP_GET, [this]() { handleSettingsPart(); });
    _server.on("/settings.js", HTTP_GET, [this]() { handleSettingsJs(); });
    _server.on("/settings-save", HTTP_POST, [this]() { handleSettingsSave(); });
  }
  if (_apMode) {
    _server.on("/wifi-test", HTTP_POST, [this]() { handleWifiTest(); });
    _server.onNotFound([this]() { handleRoot(); }); // captive portal
  }
  _server.begin();
}

void WebPortal::setMqttConfig(MqttConfigStore *mqttConfig) {
  _mqttConfig = mqttConfig;
  _server.on("/mqtt-save", HTTP_POST, [this]() { handleMqttSave(); });
  _server.on("/mqtt-test", HTTP_POST, [this]() { handleMqttTest(); });
}

void WebPortal::startCaptiveDns(IPAddress apIp) {
  _dns.start(53, "*", apIp);
  _dnsActive = true;
}

void WebPortal::loop() {
  if (_dnsActive) _dns.processNextRequest();
  crumb(C_PORTAL_CLIENT);
  _server.handleClient();
}

// Optional admin password (device settings): when set, everything that changes
// something needs HTTP basic auth (user "admin"). Plain HTTP, so it keeps casual
// LAN visitors out; it is not protection against someone sniffing the network.
// /status stays open (nothing sensitive) and the AP-mode setup page is never
// gated - it only exists when there is no working WiFi config yet.
bool WebPortal::authorized() {
  const char *pass = settingsStore.cfg.adminPass;
  if (_apMode || pass[0] == '\0') return true;
  if (_server.authenticate("admin", pass)) return true;
  _server.requestAuthentication(BASIC_AUTH, "tty2oled");
  return false;
}

void WebPortal::handleRoot() {
  if (!authorized()) return;
  String body;
  body.reserve(1024);
  body += FPSTR(PAGE_HEAD);

  if (_apMode) {
    body += "<h1>tty2oled WiFi setup</h1>"
            "<p class='muted'>Join your home WiFi network so this device "
            "is reachable at its own address instead of running its own "
            "access point.</p>"
            "<button type='button' onclick='doScan()'>Scan for networks</button>"
            "<select id='ssidList' style='width:100%;margin:.3em 0;display:none'></select>"
            "<form method='POST' action='/save'>"
            "<label>WiFi network name (SSID)</label>"
            "<input name='ssid' id='ssid' maxlength='63' required>"
            "<label>Password</label>"
            "<div class='pwrow'><input name='pass' id='wifiPass' type='password' maxlength='63'>"
            "<button type='button' onclick=\"togglePw('wifiPass',this)\" title='Show/hide password'>&#128065;</button></div>"
            "<button type='button' class='secondary' onclick='testWifi(this)'>Test connection</button>"
            "<span id='wifiTestResult'></span>"
            "<button type='submit'>Save &amp; connect</button>"
            "</form>"
            "<script>"
            "function togglePw(id,btn){"
            "var el=document.getElementById(id);"
            "var shown=el.type==='text';"
            "el.type=shown?'password':'text';"
            "btn.style.opacity=shown?1:.5"
            "}"
            "function testConn(url,body,resultId,btn){"
            "var r=document.getElementById(resultId);"
            "var origText=btn.textContent;"
            "btn.disabled=true;btn.textContent='Testing...';"
            "r.textContent='';"
            "fetch(url,{method:'POST',headers:{'Content-Type':'application/x-www-form-urlencoded'},body:body})"
            ".then(function(resp){return resp.json()})"
            ".then(function(j){r.textContent=j.ok?'\\u2713 Connected':'\\u2717 '+j.error;"
            "r.style.color=j.ok?'var(--accent2)':'var(--danger)'})"
            ".catch(function(){r.textContent='\\u2717 Request failed';r.style.color='var(--danger)'})"
            ".finally(function(){btn.disabled=false;btn.textContent=origText})"
            "}"
            "function testWifi(btn){"
            "var body='ssid='+encodeURIComponent(document.getElementById('ssid').value)"
            "+'&pass='+encodeURIComponent(document.getElementById('wifiPass').value);"
            "testConn('/wifi-test',body,'wifiTestResult',btn)"
            "}"
            "function doScan(){"
            "var sel=document.getElementById('ssidList');"
            "sel.style.display='block';"
            "sel.innerHTML='<option>Scanning...</option>';"
            "fetch('/scan').then(function(r){return r.json()}).then(function(j){"
            "sel.innerHTML='<option value=\"\">Select a network...</option>';"
            "j.networks.forEach(function(n){"
            "var opt=document.createElement('option');"
            "opt.value=n.ssid;"
            "opt.textContent=(n.open?'':'\\uD83D\\uDD12 ')+n.ssid+' ('+n.rssi+'dBm)';"
            "sel.appendChild(opt)"
            "});"
            "}).catch(function(){sel.innerHTML='<option>Scan failed</option>'})"
            "}"
            "document.getElementById('ssidList').addEventListener('change',function(){"
            "if(this.value)document.getElementById('ssid').value=this.value"
            "});"
            "</script>";
  } else {
    body += "<p><b>WiFi &amp; MQTT</b> &middot; <a href='/settings' style='color:var(--accent2)'>Settings</a></p>"
            "<h1>tty2oled status</h1>"
            "<p>Connected to <b>" + htmlEscape(_config->cfg.wifiSsid) + "</b></p>"
            "<p>IP: " + WiFi.localIP().toString() + "</p>"
            "<p class='muted'>Firmware " FW_VERSION " &middot; " REPO_URL "</p>"
            "<form method='POST' action='/reset' onsubmit=\"return confirm('Forget WiFi and restart into setup mode?');\">"
            "<button type='submit' class='danger'>Forget WiFi</button>"
            "</form>";

    if (_mqttConfig) {
      const MqttConfig &m = _mqttConfig->cfg;
      body += "<h1>MQTT notifications</h1>"
              "<p class='muted'>Subscribe to <code>&lt;prefix&gt;/text</code> and "
              "<code>&lt;prefix&gt;/image</code> (an image URL) on a broker - e.g. "
              "Home Assistant's Mosquitto add-on.</p>"
              "<form method='POST' action='/mqtt-save'>"
              "<label><input type='checkbox' name='enabled' value='1'"
              + String(m.enabled ? " checked" : "") + "> Enabled</label>"
              "<label>Broker host</label>"
              "<input name='host' id='mqttHost' maxlength='63' value='" + htmlEscape(m.host) + "'>"
              "<label>Port</label>"
              "<input name='port' type='number' min='1' max='65535' value='" + String(m.port) + "'>"
              "<label>Username (optional)</label>"
              "<input name='username' maxlength='31' value='" + htmlEscape(m.username) + "'>"
              "<label>Password (optional)</label>"
              "<div class='pwrow'><input name='password' id='mqttPass' type='password' maxlength='31' value='"
              + htmlEscape(m.password) + "'>"
              "<button type='button' onclick=\"togglePw('mqttPass',this)\" title='Show/hide password'>&#128065;</button></div>"
              "<label>Topic prefix (blank = tty2oled/&lt;device name&gt;)</label>"
              "<input name='topicPrefix' maxlength='47' value='" + htmlEscape(m.topicPrefix) + "'>"
              "<label>Notification duration (ms)</label>"
              "<input name='durationMs' type='number' min='1000' max='60000' value='" + String(m.durationMs) + "'>"
              "<button type='button' class='secondary' onclick='testMqtt(this)'>Test connection</button>"
              "<span id='mqttTestResult'></span>"
              "<button type='submit'>Save MQTT settings</button>"
              "</form>"
              "<script>"
              "function togglePw(id,btn){"
              "var el=document.getElementById(id);"
              "var shown=el.type==='text';"
              "el.type=shown?'password':'text';"
              "btn.style.opacity=shown?1:.5"
              "}"
              "function testConn(url,body,resultId,btn){"
              "var r=document.getElementById(resultId);"
              "var origText=btn.textContent;"
              "btn.disabled=true;btn.textContent='Testing...';"
              "r.textContent='';"
              "fetch(url,{method:'POST',headers:{'Content-Type':'application/x-www-form-urlencoded'},body:body})"
              ".then(function(resp){return resp.json()})"
              ".then(function(j){r.textContent=j.ok?'\\u2713 Connected':'\\u2717 '+j.error;"
              "r.style.color=j.ok?'var(--accent2)':'var(--danger)'})"
              ".catch(function(){r.textContent='\\u2717 Request failed';r.style.color='var(--danger)'})"
              ".finally(function(){btn.disabled=false;btn.textContent=origText})"
              "}"
              "function testMqtt(btn){"
              "var body='host='+encodeURIComponent(document.getElementById('mqttHost').value)"
              "+'&port='+encodeURIComponent(document.querySelector('[name=port]').value)"
              "+'&username='+encodeURIComponent(document.querySelector('[name=username]').value)"
              "+'&password='+encodeURIComponent(document.getElementById('mqttPass').value);"
              "testConn('/mqtt-test',body,'mqttTestResult',btn)"
              "}"
              "</script>";
    }
  }

  body += FPSTR(PAGE_TAIL);
  _server.send(200, "text/html", body);
}

void WebPortal::handleSave() {
  if (!authorized()) return;
  String ssid = _server.arg("ssid");
  String pass = _server.arg("pass");
  if (ssid.length() == 0 || ssid.length() >= sizeof(_config->cfg.wifiSsid)) {
    _server.send(400, "text/plain", "Invalid SSID");
    return;
  }
  strncpy(_config->cfg.wifiSsid, ssid.c_str(), sizeof(_config->cfg.wifiSsid) - 1);
  _config->cfg.wifiSsid[sizeof(_config->cfg.wifiSsid) - 1] = '\0';
  strncpy(_config->cfg.wifiPass, pass.c_str(), sizeof(_config->cfg.wifiPass) - 1);
  _config->cfg.wifiPass[sizeof(_config->cfg.wifiPass) - 1] = '\0';
  _config->cfg.configured = true;
  _config->save();

  String body;
  body += FPSTR(PAGE_HEAD);
  body += "<h1>Saved</h1><p>Restarting and connecting to "
          + htmlEscape(ssid) + "&hellip;</p>";
  body += FPSTR(PAGE_TAIL);
  _server.send(200, "text/html", body);

  delay(300); // let the response actually flush before restarting
  ESP.restart();
}

void WebPortal::handleReset() {
  if (!authorized()) return;
  _config->reset();
  String body;
  body += FPSTR(PAGE_HEAD);
  body += "<h1>WiFi forgotten</h1><p>Restarting into setup mode&hellip;</p>";
  body += FPSTR(PAGE_TAIL);
  _server.send(200, "text/html", body);

  delay(300);
  ESP.restart();
}

void WebPortal::handleMqttSave() {
  if (!authorized()) return;
  MqttConfig &m = _mqttConfig->cfg;
  m.enabled = _server.hasArg("enabled");
  strncpy(m.host, _server.arg("host").c_str(), sizeof(m.host) - 1);
  m.host[sizeof(m.host) - 1] = '\0';
  m.port = (uint16_t)_server.arg("port").toInt();
  if (m.port == 0) m.port = 1883;
  strncpy(m.username, _server.arg("username").c_str(), sizeof(m.username) - 1);
  m.username[sizeof(m.username) - 1] = '\0';
  strncpy(m.password, _server.arg("password").c_str(), sizeof(m.password) - 1);
  m.password[sizeof(m.password) - 1] = '\0';
  strncpy(m.topicPrefix, _server.arg("topicPrefix").c_str(), sizeof(m.topicPrefix) - 1);
  m.topicPrefix[sizeof(m.topicPrefix) - 1] = '\0';
  m.durationMs = (uint16_t)_server.arg("durationMs").toInt();
  if (m.durationMs < 1000) m.durationMs = 8000;
  _mqttConfig->save();

  String body;
  body += FPSTR(PAGE_HEAD);
  body += "<h1>MQTT settings saved</h1><p>Restarting to apply&hellip;</p>";
  body += FPSTR(PAGE_TAIL);
  _server.send(200, "text/html", body);

  // Simplest reliable way to apply new broker settings - mqtt_client.cpp
  // only reads MqttConfigStore once, at mqtt_client_init(). A restart is
  // cheap here (device is already on WiFi, reconnects immediately) and
  // avoids adding a second "re-init the MQTT client live" code path.
  delay(300);
  ESP.restart();
}

void WebPortal::handleWifiTest() {
  String ssid = _server.arg("ssid");
  String pass = _server.arg("pass");

  String error;
  bool ok = wifi_manager_test_connection(ssid, pass, error);

  String json = "{\"ok\":" + String(ok ? "true" : "false");
  if (!ok) json += ",\"error\":\"" + htmlEscape(error) + "\"";
  json += "}";
  _server.send(200, "application/json", json);
}

void WebPortal::handleMqttTest() {
  if (!authorized()) return;
  String host = _server.arg("host");
  uint16_t port = (uint16_t)_server.arg("port").toInt();
  if (port == 0) port = 1883;
  String username = _server.arg("username");
  String password = _server.arg("password");

  String error;
  bool ok = mqtt_client_test(host, port, username, password, error);

  String json = "{\"ok\":" + String(ok ? "true" : "false");
  if (!ok) json += ",\"error\":\"" + htmlEscape(error) + "\"";
  json += "}";
  _server.send(200, "application/json", json);
}

void WebPortal::handleScan() {
  if (!authorized()) return;
  // Synchronous WiFi.scanNetworks() - same pattern as chromecast-esp32's
  // /wifiscan. Blocks a few seconds, which is fine here: this only runs
  // in AP mode, on-demand from a button click on the setup form, not on
  // any hot path.
  int n = WiFi.scanNetworks();
  String json = "{\"networks\":[";
  for (int i = 0; i < n && i < 20; i++) {
    if (i > 0) json += ",";
    json += "{\"ssid\":\"" + htmlEscape(WiFi.SSID(i)) + "\",";
    json += "\"rssi\":" + String(WiFi.RSSI(i)) + ",";
    json += "\"open\":" + String(WiFi.encryptionType(i) == WIFI_AUTH_OPEN ? "true" : "false");
    json += "}";
  }
  json += "]}";
  WiFi.scanDelete();
  _server.send(200, "application/json", json);
}

void WebPortal::handleStatus() {
  crumb(C_STATUS_BEGIN);
  String json = "{";
  json += "\"apMode\":" + String(_apMode ? "true" : "false") + ",";
  json += "\"ssid\":\"" + htmlEscape(_apMode ? WiFi.softAPSSID() : String(_config->cfg.wifiSsid)) + "\",";
  json += "\"ip\":\"" + (_apMode ? WiFi.softAPIP().toString() : WiFi.localIP().toString()) + "\"";
  if (!_apMode) json += ",\"rssi\":" + String(WiFi.RSSI()); // dBm: -50 great, -70 marginal, -80 poor
  json += ",\"txpower\":" + String(wifi_manager_tx_power(), 1); // dBm
  json += "," + wifi_manager_diag_json();
  json += ",\"ver\":\"" FW_VERSION "\",\"name\":\"" + wifi_manager_device_name() + "\"";
  json += ",\"uptime\":" + String(millis() / 1000);
  json += ",\"contrast\":" + String(display_get_contrast());
  if (light_sensor_present()) json += ",\"ldr\":" + String(light_sensor_raw());
  if (touch_present()) json += ",\"touch\":" + String(touch_pressure());
  json += ",\"heap\":" + String(ESP.getFreeHeap()) + ",\"heap_max\":" + String(ESP.getMaxAllocHeap());
  String hm, date;
  json += ",\"time\":\"" + (time_get_strings(hm, date) ? hm + " " + date : String("")) + "\"";
  json += String(",\"ntp\":\"") + time_ntp_state() + "\",\"stage\":\"" + protocol_idle_stage() + "\"";
  json += String(",\"mqtt\":\"") + mqtt_client_status() + "\"";
  json += String(",\"auth\":") + (settingsStore.cfg.adminPass[0] ? "true" : "false");
  json += ",\"crumb_prev\":" + String(crumb_prev()) + ",\"reset\":" + String(reset_reason_raw());
  json += "}";
  _server.send(200, "application/json", json);
}
