doccaz/mister-tty2oled-esp32/firmware/src/device_settings.h

// SPDX-License-Identifier: GPL-3.0-or-later
// Copyright (C) 2026 Erico Mendonca

#pragma once

// User-editable device settings, edited on the web page that runs on the
// device itself once it's on WiFi (web_portal.cpp "/settings") and kept in NVS
// so they survive power cycles. They are *boot defaults*: apply them at power-up
// and whenever the page changes them. A live command from the MiSTer
// (CMDCON/CMDROT/CMDSAVER) still overrides the running value until the next
// reboot, so an unmodified tty2oled.sh keeps working.

#include <Arduino.h>
#include <Preferences.h>

enum TintMode : uint8_t {
  TINT_OFF = 0,
  TINT_FIXED = 1,    // one colour
  TINT_GRADIENT = 2, // colour 1 -> colour 2
  TINT_RANDOM = 3,   // a new random colour for every picture
};

struct DeviceSettings {
  uint8_t contrast;      // 0-255 backlight
  bool autoBright;       // follow the room light (boards with a light sensor only)
  uint8_t autoMin;       // auto brightness range
  uint8_t autoMax;
  bool transferLed;      // RGB LED shows picture transfers (boards with the LED only)
  uint8_t rotation;      // quarter turns: 0 normal, 1 = 90, 2 = 180, 3 = 270 degrees

  uint16_t clockIdleMin; // minutes idle before the clock replaces the picture (0 = never)
  uint16_t blankMin;     // further minutes before the screen goes dark (0 = never); counted from idle start when the clock is off
  uint16_t oledIdleSec;  // onboard OLED blanks after this many idle seconds (0 = never)

  bool ntpEnabled;
  char ntpServer[48];
  char tz[48];           // POSIX TZ string, e.g. "<-03>3" or "CET-1CEST,M3.5.0,M10.5.0/3"

  char adminPass[32];    // empty = the settings page is open on the LAN

  uint8_t tintMode;      // TintMode, applies to legacy 1bpp/4bpp pictures and grayscale JPEGs
  uint32_t tintColor1;   // 0xRRGGBB
  uint32_t tintColor2;   // 0xRRGGBB, gradient end
  uint8_t tintDir;       // gradient: 0 top-to-bottom, 1 left-to-right

  void setDefaults() {
    contrast = 127; // 255 was too bright on the Sunton board
    autoBright = false;
    autoMin = 16;
    autoMax = 255;
    transferLed = true;
    rotation = 0;
    clockIdleMin = 15; // idle clock after 15 min (only shown once the time is known); 0 = never
    blankMin = 0;
    oledIdleSec = 60;
    ntpEnabled = true;
    strncpy(ntpServer, "pool.ntp.org", sizeof(ntpServer));
    strncpy(tz, "UTC0", sizeof(tz));
    adminPass[0] = '\0';
    tintMode = TINT_OFF;
    tintColor1 = 0xFFB000; // warm amber
    tintColor2 = 0x00A0FF; // blue
    tintDir = 0;
  }
};

class DeviceSettingsStore {
 public:
  DeviceSettings cfg;

  void begin() {
    cfg.setDefaults();
    _prefs.begin("tty2oled", false); // same namespace as the WiFi config; keys are prefixed "s_"
    load();
  }

  void load() {
    cfg.contrast = _prefs.getUChar("s_contrast", cfg.contrast);
    cfg.autoBright = _prefs.getBool("s_abr", cfg.autoBright);
    cfg.autoMin = _prefs.getUChar("s_amin", cfg.autoMin);
    cfg.autoMax = _prefs.getUChar("s_amax", cfg.autoMax);
    cfg.transferLed = _prefs.getBool("s_led", cfg.transferLed);
    // "s_rot4" holds quarter turns 0-3. Older firmware stored only "s_rot" (0/1,
    // where 1 meant 180 degrees), so fall back to that and map 1 -> 2.
    if (_prefs.isKey("s_rot4")) cfg.rotation = _prefs.getUChar("s_rot4", 0) & 3;
    else cfg.rotation = _prefs.getUChar("s_rot", 0) ? 2 : 0;
    cfg.clockIdleMin = _prefs.getUShort("s_clockMin", cfg.clockIdleMin);
    cfg.blankMin = _prefs.getUShort("s_blankMin", cfg.blankMin);
    cfg.oledIdleSec = _prefs.getUShort("s_oledSec", cfg.oledIdleSec);
    cfg.ntpEnabled = _prefs.getBool("s_ntp", cfg.ntpEnabled);
    getStr("s_ntpSrv", cfg.ntpServer, sizeof(cfg.ntpServer));
    getStr("s_tz", cfg.tz, sizeof(cfg.tz));
    getStr("s_admin", cfg.adminPass, sizeof(cfg.adminPass));
    cfg.tintMode = _prefs.getUChar("s_tintMode", cfg.tintMode);
    cfg.tintColor1 = _prefs.getUInt("s_tint1", cfg.tintColor1);
    cfg.tintColor2 = _prefs.getUInt("s_tint2", cfg.tintColor2);
    cfg.tintDir = _prefs.getUChar("s_tintDir", cfg.tintDir);
  }

  void save() {
    _prefs.putUChar("s_contrast", cfg.contrast);
    _prefs.putBool("s_abr", cfg.autoBright);
    _prefs.putUChar("s_amin", cfg.autoMin);
    _prefs.putUChar("s_amax", cfg.autoMax);
    _prefs.putBool("s_led", cfg.transferLed);
    _prefs.putUChar("s_rot4", cfg.rotation);
    _prefs.putUShort("s_clockMin", cfg.clockIdleMin);
    _prefs.putUShort("s_blankMin", cfg.blankMin);
    _prefs.putUShort("s_oledSec", cfg.oledIdleSec);
    _prefs.putBool("s_ntp", cfg.ntpEnabled);
    _prefs.putString("s_ntpSrv", cfg.ntpServer);
    _prefs.putString("s_tz", cfg.tz);
    _prefs.putString("s_admin", cfg.adminPass);
    _prefs.putUChar("s_tintMode", cfg.tintMode);
    _prefs.putUInt("s_tint1", cfg.tintColor1);
    _prefs.putUInt("s_tint2", cfg.tintColor2);
    _prefs.putUChar("s_tintDir", cfg.tintDir);
  }

 private:
  void getStr(const char *key, char *out, size_t size) {
    if (!_prefs.isKey(key)) return; // keep the default
    _prefs.getString(key, out, size);
  }
  Preferences _prefs;
};

// The one shared instance (defined in device_settings.cpp), loaded by main.cpp's setup().
extern DeviceSettingsStore settingsStore;
