doccaz/mister-tty2oled-esp32/firmware/src/ws_protocol.cpp

// SPDX-License-Identifier: GPL-3.0-or-later
// Copyright (C) 2026 Erico Mendonca

#include "ws_protocol.h"
#include "protocol.h"
#include "oled_status.h"
#include "version.h"
#include <WebSocketsServer.h>

// Opt-in diagnostics for transfer failures: build with PLATFORMIO_BUILD_FLAGS="-DWS_DIAG=1".
// Prints to the serial port (the CYD's USB serial is also the picture channel, so never ship it on).
#if defined(WS_DIAG)
#define DIAG(...) Serial.printf("[ws] %lu ", millis()), Serial.printf(__VA_ARGS__)
#else
#define DIAG(...) ((void)0)
#endif

namespace {
size_t g_diagRx = 0; // bytes of the current transfer received (diagnostics)
// Client that began the transfer in flight, -1 when none. A disconnect of any OTHER client
// (the menu's test sender, a web app tab) must not abort someone else's picture, and a
// transfer owned by MQTT (never claimed here) is never aborted by a WebSocket disconnect.
int g_xferOwner = -1;

WebSocketsServer wsServer(81);
bool wsReady = false;

// Tiny local comma-split helper for the one WS-specific text grammar
// (CMDCORC's header fields) - protocol.cpp's own splitField() is
// file-local there, and duplicating one small helper here is cheaper and
// safer than exposing protocol.cpp's internals just for this.
String field(const String &s, int index) {
  int start = 0;
  int comma = -1;
  for (int i = 0; i <= index; i++) {
    comma = s.indexOf(',', start);
    if (comma == -1) return (i == index) ? s.substring(start) : "";
    if (i == index) return s.substring(start, comma);
    start = comma + 1;
  }
  return "";
}

void handleText(uint8_t num, uint8_t *payload, size_t length) {
  // WebSockets malloc()s text payloads with one extra byte for a null
  // terminator (see WebSockets.cpp) - safe to treat as a C string.
  String line = String(reinterpret_cast<char *>(payload));
  line.trim();
  if (line.length() == 0) return;

  if (line.startsWith("CMDCORC")) {
    g_diagRx = 0;
    DIAG("CMDCORC begin %.60s heap=%u max=%u\n", line.c_str(), (unsigned)ESP.getFreeHeap(), (unsigned)ESP.getMaxAllocHeap());
    protocol_note_command(line);
    protocol_note_activity(); // a long picture transfer must keep the displays awake, not just its final ack
    String name = field(line, 1);
    int effect = field(line, 2).toInt();
    long durationMs = field(line, 3).toInt();
    long totalLen = field(line, 4).toInt();
    if (totalLen <= 0 || !protocol_ws_xfer_begin(name, (uint8_t)effect, (uint16_t)durationMs, (size_t)totalLen)) {
      wsServer.sendTXT(num, "ERR CMDCORC;");
      return;
    }
    g_xferOwner = num;
    // No ttyack here - one is sent once the chunked binary transfer
    // completes (see handleBinary()), matching the serial path's "ack
    // after the whole picture is drawn" behavior.
    return;
  }

  if (line == "CMDHWINF") {
    protocol_note_command(line);
    // The only command that replies - special-cased here instead of
    // going through protocol_dispatch_line(), which would write the
    // reply to Serial (the wrong transport for a WS client). Same
    // grammar as the serial reply, see protocol.cpp.
    wsServer.sendTXT(num, HW_ID ";" FW_VERSION ";");
    protocol_note_activity();
    return;
  }

  DIAG("text '%.40s' heap=%u max=%u\n", line.c_str(), (unsigned)ESP.getFreeHeap(), (unsigned)ESP.getMaxAllocHeap());
  g_diagRx = 0;
  protocol_dispatch_line(line);
  protocol_note_activity();
  wsServer.sendTXT(num, "ttyack;");
}

void handleBinary(uint8_t num, uint8_t *payload, size_t length) {
  DIAG("bin %u in_progress=%d total=%u\n", (unsigned)length, protocol_ws_xfer_in_progress(), (unsigned)(g_diagRx += length));
  if (!protocol_ws_xfer_in_progress() || num != g_xferOwner) return; // no transfer pending, or not this client's - malformed client, ignore

  // Same hazard as the serial picture path: an I2C sendBuffer() (~20ms)
  // can starve wsServer.loop()'s TCP servicing mid-transfer if it isn't
  // suspended around the append, exactly like protocol.cpp's readExact()
  // wraps its reads (see CLAUDE.md "Onboard status OLED").
  oled_status_suspend();
  bool ok = protocol_ws_xfer_append(payload, length);
  oled_status_resume();

  if (!ok) {
    wsServer.sendTXT(num, "ERR xfer overflow;");
    return;
  }
  if (protocol_ws_xfer_complete()) {
    protocol_ws_xfer_finish();
    g_xferOwner = -1;
    protocol_note_activity();
    wsServer.sendTXT(num, "ttyack;");
  }
}

void onWsEvent(uint8_t num, WStype_t type, uint8_t *payload, size_t length) {
  switch (type) {
    case WStype_TEXT:
      handleText(num, payload, length);
      break;
    case WStype_BIN:
      handleBinary(num, payload, length);
      break;
    case WStype_CONNECTED:
      DIAG("client %u connected\n", num);
      break;
    case WStype_DISCONNECTED:
      DIAG("client %u disconnected in_progress=%d got=%u\n", num, protocol_ws_xfer_in_progress(), (unsigned)g_diagRx);
      // Don't leave a half-received transfer stuck waiting for chunks
      // that will never arrive from a client that's gone - but only when it
      // is the client that owns the transfer (see g_xferOwner).
      if (protocol_ws_xfer_in_progress() && num == g_xferOwner) {
        protocol_ws_xfer_abort();
        g_xferOwner = -1;
      }
      break;
    default:
      break;
  }
}

} // namespace

void ws_protocol_init() {
  wsServer.begin();
  wsServer.onEvent(onWsEvent);
  wsReady = true;
}

void ws_protocol_loop() {
  if (wsReady) wsServer.loop();
}
