doccaz/mister-tty2oled-esp32/firmware/src/version.h

// SPDX-License-Identifier: GPL-3.0-or-later
// Copyright (C) 2026 Erico Mendonca

#pragma once

// Shared by protocol.cpp (CMDHWINF reply, CMDSHSYSHW screen), display.cpp
// (boot splash), and oled_status.cpp (status dashboard) - single place to
// bump on release.
#define FW_VERSION "0.7.1"
// No "github.com/" prefix - the full URL (~240px at the boot splash's
// 6px/char font) is wider than the display itself; this shorter form
// still reads as a findable repo path.
#define REPO_URL "doccaz/mister-tty2oled-esp32"

// Hardware id answered to CMDHWINF, advertised over mDNS and sent on the WebSocket.
#if defined(BOARD_CYD)
#define HW_ID "HWCYD28"
#else
#define HW_ID "HWGC9A01C"
#endif
