doccaz/mister-tty2oled-esp32/(commit log)

2026-10-13 README: add 3D-printed case video and web UI screenshot; strip audio from demo videos
2026-10-13 README: embed the case demo video via attachment URL
2026-10-14 Ignore bare serial lines with control bytes (Zaparoo PN532 probe drew garbage)
    Zaparoo's PN532 auto-detect writes 0x55 0x55 0x00... to every /dev/ttyACM* after each core change; the bare-corename fallback drew it as text. Drop bare lines containing bytes outside 0x20-0x7E. Document the finding in README and CLAUDE.md.
2026-10-14 Add web flasher and GitHub Pages workflow
    ESP Web Tools page with a board picker, merged flash images per board, and the marquee web app published under /app/. tools/build_site.sh assembles the site; the workflow builds it on v* tags. importLibrary.ts now uses BASE_URL so the app works under a sub-path; the local third-party art pack is stripped from the build.
2026-10-14 Pin PlatformIO platform to the tested Tasmota 2024.06.00 release
    A bare 'espressif32' resolves to whichever matching platform is installed, so CI built with the registry's 6.x (Arduino 2.0.17, ~1 MB image) while local builds used Tasmota's 2024.06.00 (Arduino 2.0.18). Pin the exact release so both agree.
2026-10-14 Web app: library backup/restore, wrapping header, vite env types
    Back up / Restore buttons export and merge the IndexedDB art library as JSON (JPEG and PNG blobs, newer-wins merge). Header wraps instead of overflowing; add vite/client types so import.meta.env type-checks.
2026-10-14 Revert "Pin PlatformIO platform to the tested Tasmota 2024.06.00 release"
    This reverts commit 10cb54621bbfe426303bcf2db057a19fc725b877.
2026-10-14 Pages: publish the release's tested firmware images instead of building in CI
    A clean PlatformIO build resolves to a different Arduino toolchain than the locally tested one (and the Tasmota pin can't build on a clean machine), so the workflow now downloads the release's merged .bin assets. Triggers on release published or manually with an optional tag.
2026-10-14 Web app: page the library and review table, shared DB connection, list saved cores after reload
    Importing a ~1900-file folder froze the page: ~1900 library cards plus a ~1900-row flex review list. The library now draws 300 cards per category with Show more and a filter box; the review modal adds rows 400 at a time (checked state in a Map); .review-list is a block container; db.ts shares one IndexedDB connection and Save writes in one transaction; saved cores missing from the catalog are added on boot so they survive a reload without a pack index; folder names are HTML-escaped. Verified with the real 1890-file GSC folder in a browser.
2026-10-14 App: fit JPEGs to the device's 20 KB buffer, encode before clearing, surface device errors
    The firmware rejects CMDCORC pictures over its static 20,000-byte buffer with ERR CMDCORC. The editor exported at a fixed quality, so a detailed image was refused after 'blank first' had already cleared the screen, leaving it black while the app showed nothing. exportJpegFit() lowers quality until the JPEG fits, sendPreview() encodes before clearing, and WifiLink fails the pending send on an ERR reply instead of waiting out the ack timeout.
2026-10-14 Firmware: WiFi power-save off, join retries, OLED idle blank + live command line
    Default WiFi modem-sleep caused 47% packet loss and multi-second acks on the Super Mini; setSleep(false) gives 0% loss and ~22 ms RTT. Joining the saved network now makes 3 attempts and an AP-mode device reboots to retry it when idle. /status reports rssi and txpower; CMDWTX sets TX power live. The onboard OLED blanks after 60 s idle and shows the last command received.
    [display.cpp, display.h, mqtt_client.cpp, oled_status.cpp, protocol.cpp, protocol.h, web_portal.cpp, wifi_manager.cpp]
2026-10-14 Flash the firmware as separate parts so saved WiFi/MQTT settings survive
    A merged image fills the gaps between partitions with 0xFF, which overwrites the NVS partition (verified: 20480 bytes of 0xFF at 0x9000), so flashing it - from the web flasher or esptool - wiped the saved WiFi config and the device booted into AP setup mode. The flasher manifests now write bootloader/partitions/boot_app0/app at their own offsets, release.sh attaches those parts (and checks they reproduce each full image), and the full-chip images are documented as fresh-device only.
2026-10-14 AP mode: power-save off; Test connection waits 20 s with a retry and fails fast on a wrong password
    The setup page's Test connection used to give up after 10 s ('Timed out connecting') for a network the device joins fine at boot - joins take 3-10 s and the AP_STA radio is slower. Also turn WiFi power-save off in AP mode.
    [wifi_manager.cpp]
2026-10-14 WiFi: join diagnostics on /status, radio-tuning hooks (off by default), measured results
    /status now reports join_ms, disc_count and the last disconnect reason. 15-reboot A/B runs: first-association failures (reason 204 handshake timeout) in 5/15 boots at default settings; 11 dBm TX power made it far worse (11/11) and 20 MHz width was inconclusive (2/15 then 6/10), so both knobs stay off by default. Retries plus the AP-mode self-retry are what absorb it.
    [web_portal.cpp, wifi_manager.cpp, wifi_manager.h]
2026-10-14 Device settings page, idle clock + blank, NTP/timezone, admin password, monochrome tint; bump to 0.5.0
    Settings are served as a small shell plus fragments: one large chunked
    response stalled on the lwip send buffer and hung the loop (see CLAUDE.md).
    [device_settings.h, diag.cpp, diag.h, display.cpp, display.h, main.cpp, mqtt_client.cpp]
2026-10-16 Web app: Status/Settings buttons for the device pages when connected over WiFi
2026-10-16 Add 3D-printable screw-on case for the Sunton ESP32-2424S012C
    Parametric OpenSCAD source plus exported STLs: a cup with the bezel window,
    glass guide pads and USB-C window, and a threaded plug back with a coin slot.
    Print-tested on real hardware.
    [sunton_2424s012_back.stl, sunton_2424s012_case.scad, sunton_2424s012_front.stl]
2026-10-16 README: add a section for the 3D-printable case
2026-10-16 README: photo of the printed case
2026-10-16 CLAUDE.md: document the printed case
2026-10-16 Case: optional pedestal disc on the plug to limit board sag
    [sunton_2424s012_back.stl, sunton_2424s012_case.scad]
2026-10-17 Case: smaller PCB pocket (38.2 mm) and tighter pedestal gap (0.3 mm)
    Re-exported both STLs from the current .scad (outer diameter 45.5 mm).
    [sunton_2424s012_back.stl, sunton_2424s012_case.scad, sunton_2424s012_front.stl]
2026-10-17 Docs: update case dimensions and pedestal notes
2026-10-17 Case: desk stand with cable notches and embossed MiSTer-Kun mascot
    [mister_kun_logo.scad, sunton_2424s012_stand.scad, sunton_2424s012_stand.stl]
2026-10-21 mister: auto-update via a Downloader database and a self-update command
    Two ways to keep the WiFi daemon current on a MiSTer:
    - Automatic with update_all: publish a MiSTer Downloader custom database
    (tools/build_mister_db.py -> a plain t2o-wifi-db.json at a stable Pages
    URL). It lists the binary (reboot:true), the init script, the Scripts
    wrapper, and t2o-wifi.ini with overwrite:false so a user's HOST/settings
    are never clobbered. release.sh builds and uploads the four assets
    (VERSION pinned to the tag so MD5s match); build_site.sh regenerates and
    publishes the db from them and fails loudly in CI if any asset is
    missing; pages.yml downloads the daemon assets too.
    - Manual: `t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
2026-10-21 README: photo of the Sunton case + desk stand (3D-printable, in case/)
2026-10-21 Rename project to mister-tty2oled-esp32; bump firmware to 0.5.5
    Panel-neutral name ahead of possible rectangular-panel support. Changes
    project identity only - Pages/GitHub URLs, Go module path, REPO_URL, the
    daemon's default update-DB URL, flasher branding, and web links. Kept
    unchanged because they're decoupled identities (not the repo name): the
    Downloader db_id, the library backup format string, the HWGC9A01C hw id,
    and the firmware release-asset prefix (panel-accurate). Local working dir
    stays mister-tty2oled-gc9a01.
2026-10-21 CLAUDE.md: local dir renamed to mister-tty2oled-esp32 too (memory slug migrated alongside)
2026-10-22 web: art-set selector (Color / Grayscale) with safe re-seed
    Header dropdown picks which marquee set auto-assigned cores pull from.
    findAutoMatch now takes an ArtSource and ranks candidates: Color prefers a
    color render then falls back to grayscale; Grayscale uses the gsc/xbm packs
    only. Switching re-seeds every auto-assigned core from the chosen set.
    Records are tagged autoSeed (true = pack match, safe to replace; false =
    hand-saved editor export, never touched; undefined legacy = treated as
    auto-seeded) plus the source entry URL, so the switch only rewrites
    replaceable cores and skips ones already showing the right art. This same
    mechanism upgrades existing installs from the old gray auto-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
2026-10-22 themes: fix NES (native colors) and MSX (drop bg rect)
    - NES was style 'svg', which recolored its full-colour US logo (red pill,
    white Nintendo, black subtitle) into a muddy monochrome red. Switch to
    'native' so the real red-pill + white-text logo shows.
    - MSX/MSX1 SVG carries a full-canvas near-black background rect that the
    sheen recolored into a red box; removed it from the local SVG so the red
    MSX wordmark floats on the themed bg (noted, like Archimedes).
2026-10-22 themes: NES subtitle readable + MSX/Amiga to cool silver
    - NES: recolor the black 'ENTERTAINMENT SYSTEM' subtitle to light grey in
    the local SVG so it reads on the dark bg (it was invisible under native).
    - MSX/MSX1/Amiga: owner found red off; switch to a faintly-cool silver
    (#dbe4f2) - chromatic on purpose so the firmware's all-grayscale CMDCORC
    re-tint never kicks in, while reading as clean silver/white.
2026-10-22 themes: Amiga uses the classic 1985 rainbow logo
    Owner noted the real Amiga logo has the rainbow checkmark. Switch from the
    Minimig gradient-map to the PD File:Amiga-Logo-1985.svg (native, keeps the
    green->red rainbow tick), black 'Amiga' wordmark recolored light in the
    local SVG so it reads on the dark bg. Minimig master kept as fallback.
2026-10-22 firmware: hide status-OLED idle-blank setting on boards without the OLED
    The /settings 'Blank the status OLED after' field showed on every build,
    but the nooled and Sunton (2424s012) boards have no onboard status OLED
    (HAS_ONBOARD_OLED=0). Wrap the field in #if HAS_ONBOARD_OLED so it only
    appears on env:esp32c3. Save side was already safe (clampArg keeps the
    stored value when the field is absent). Both envs build clean.
2026-10-22 web: Grayscale art set hides colour-only cores, without touching user art
    Switching the art set now clears library-sourced art for cores that have
    no art in the chosen set (so they show as not found), instead of leaving
    colour art visible under Grayscale. Only records whose sourceUrl is in the
    bundled library index (or old untagged PNG seeds) are replaced or cleared;
    hand-saved, imported-folder and restored-backup art is never touched.
2026-10-23 mister: art-pd lookup, menu test picker; tools: public-domain art pack release
    The daemon now looks in art/, pics_pri, then art-pd/ (the Downloader-installed pack) at each
    name length. 'Send a test picture' offers current/random/pick-from-list/type for joystick
    users, and its notice no longer vanishes on the status refresh. tools/build_art_db.py and
    tools/release_art.sh publish the public-domain set as release art-pd-N (not latest) with a
    second Downloader database that Pages regenerates on every deploy.
2026-10-24 firmware: CYD (ESP32-2432S028) board support, phase 1 (USB)
2026-10-24 firmware: CYD without a decoded frame (JPEG re-decode per step), WiFi/AP working, dev WiFi shortcut
    [display.cpp, wifi_manager.cpp]
2026-10-24 docs: CYD brightness confirmed on the real board
2026-10-24 firmware: auto brightness from the CYD light sensor, contrast and ldr in /status
2026-10-24 firmware: CYD touch wake (XPT2046 pressure, no factory reset via touch)
    [pins.h, protocol.cpp, touch.cpp, touch.h, web_portal.cpp]
2026-10-24 release: classic-ESP32 CYD images, optional CYD flasher entry, dev WiFi shortcut made opt-in with a release credential guard
    [wifi_manager.cpp]
2026-10-24 docs: rewrite Future implementations (wireless MiSTer support is built; list the real open items)
2026-10-26 Rename project from tty2oled-gc9a01 to mister-tty2oled-esp32
2026-10-27 docs: Zaparoo probe vs CYD pictures - explicit reader entry, by-path TTYDEV, upstream issue refs
2026-10-27 docs: Zaparoo probe does not affect the WiFi daemon path
2026-10-28 CYD: RGB LED shows picture transfers; build on Arduino-ESP32 3.x without pinning
2026-10-28 Device name from eFuse MAC (WiFi.macAddress() is zeros before WiFi starts on core 3.x)
2026-10-28 docs: the 7-pin GC9A01 module has no BL pin, so no brightness control
2026-10-28 Idle clock after 15 minutes by default on all boards
2026-10-30 README: slim the front page to the essentials, move reference material to docs/
2026-11-06 firmware: CYD 90/270 orientation rotated instead of mirroring
    MADCTL 0xE0/0x20 kept the row/column exchange (MV) and flipped one mirror
    bit, so the quarter turns mirrored the picture. Clear MV for 90/270
    (0xC0/0x00) and move the 240x240 canvas offset from X to Y, since the
    panel then addresses as 240x320. Verified on a CYD in all four
    orientations.
    [gc9a01.cpp, gc9a01.h]
